haz05/TCC--Batuta_Eletronica/README.md

Batuta Eletrônica para Inclusão de Músicos com Deficiência Visual em Orquestras Sinfônicas

Vitor Fernandes Bastos Pasqualino - Universidade Federal de Santa Maria
