haz05/TCC--Batuta_Eletronica/Dados/Dados-Emissor/teste-vitor.csv

Sample Number (1000 samples per second) | UNIX Timestamp (Milliseconds since 1970-01-01) | aX () | aY () | aZ () | gX () | gY () | gZ () | sinal () | validação ()
0 | 1650320267236 | 22.0 | -564.0 | -825.0 | -2.0 | -6.0 | -6.0 | 0.0 | 0.0
1 | 1650320267239 | 22.0 | -565.0 | -822.0 | -2.0 | -6.0 | -6.0 | 0.0 | 0.0
2 | 1650320267244 | 22.0 | -566.0 | -817.0 | -2.0 | -7.0 | -6.0 | 0.0 | 0.0
3 | 1650320267253 | 21.0 | -567.0 | -813.0 | -1.0 | -7.0 | -5.0 | 0.0 | 0.0
4 | 1650320267259 | 19.0 | -568.0 | -810.0 | -1.0 | -7.0 | -4.0 | 0.0 | 0.0
5 | 1650320267269 | 16.0 | -569.0 | -808.0 | 0.0 | -6.0 | -3.0 | 0.0 | 0.0
6 | 1650320267276 | 15.0 | -569.0 | -805.0 | 0.0 | -6.0 | -2.0 | 0.0 | 0.0
7 | 1650320267285 | 13.0 | -568.0 | -804.0 | 1.0 | -5.0 | -1.0 | 0.0 | 0.0
8 | 1650320267292 | 13.0 | -567.0 | -804.0 | 2.0 | -5.0 | 0.0 | 0.0 | 0.0
9 | 1650320267301 | 15.0 | -564.0 | -805.0 | 3.0 | -5.0 | 0.0 | 0.0 | 0.0
10 | 1650320267307 | 18.0 | -561.0 | -806.0 | 4.0 | -4.0 | 1.0 | 0.0 | 0.0
11 | 1650320267317 | 22.0 | -558.0 | -808.0 | 4.0 | -4.0 | 2.0 | 0.0 | 0.0
12 | 1650320267325 | 28.0 | -557.0 | -809.0 | 5.0 | -3.0 | 2.0 | 0.0 | 0.0
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
