haz05/TCC--Batuta_Eletronica/Dados/Dados-Emissor/teste-vitor2.csv

Sample Number (1000 samples per second) | UNIX Timestamp (Milliseconds since 1970-01-01) | aX () | aY () | aZ () | gX () | gY () | gZ () | sinal () | validação ()
0 | 1650323412721 | 618.0 | -165.0 | -791.0 | 3.0 | -3.0 | -3.0 | 0.0 | 0.0
1 | 1650323412730 | 619.0 | -166.0 | -791.0 | 3.0 | -3.0 | -3.0 | 0.0 | 0.0
2 | 1650323412730 | 619.0 | -165.0 | -790.0 | 3.0 | -3.0 | -3.0 | 0.0 | 0.0
3 | 1650323412730 | 619.0 | -165.0 | -790.0 | 3.0 | -3.0 | -3.0 | 0.0 | 0.0
4 | 1650323412730 | 619.0 | -165.0 | -790.0 | 3.0 | -3.0 | -3.0 | 0.0 | 0.0
5 | 1650323412738 | 618.0 | -164.0 | -790.0 | 3.0 | -3.0 | -3.0 | 0.0 | 0.0
6 | 1650323412745 | 618.0 | -165.0 | -789.0 | 3.0 | -3.0 | -3.0 | 0.0 | 0.0
7 | 1650323412753 | 618.0 | -165.0 | -789.0 | 3.0 | -2.0 | -3.0 | 0.0 | 0.0
8 | 1650323412760 | 619.0 | -165.0 | -789.0 | 3.0 | -2.0 | -3.0 | 0.0 | 0.0
9 | 1650323412771 | 619.0 | -165.0 | -789.0 | 3.0 | -2.0 | -3.0 | 0.0 | 0.0
10 | 1650323412776 | 620.0 | -165.0 | -789.0 | 2.0 | -2.0 | -3.0 | 0.0 | 0.0
11 | 1650323412785 | 620.0 | -165.0 | -789.0 | 2.0 | -3.0 | -3.0 | 0.0 | 0.0
12 | 1650323412794 | 620.0 | -166.0 | -789.0 | 2.0 | -3.0 | -3.0 | 0.0 | 0.0
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
