haz05/TCC--Batuta_Eletronica/Arquivos/Documentos_CAD/placa_E1.pdf

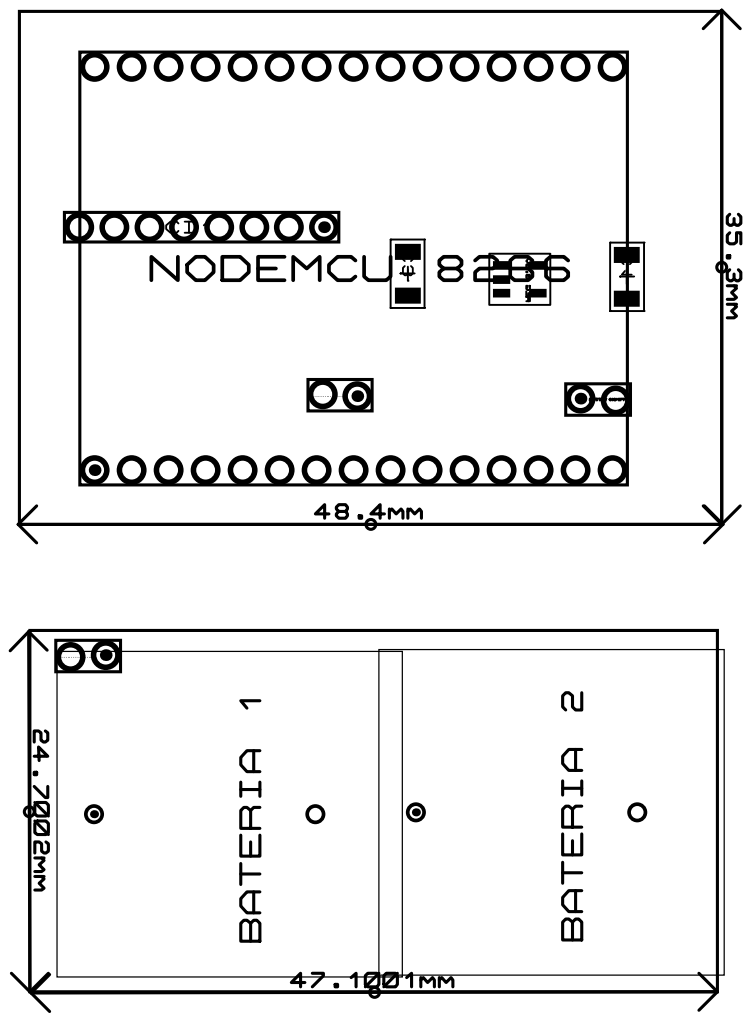
[picture p62: page 1]
