haz05/TCC--Batuta_Eletronica/Arquivos/Documentos_CAD/placa_E2.pdf

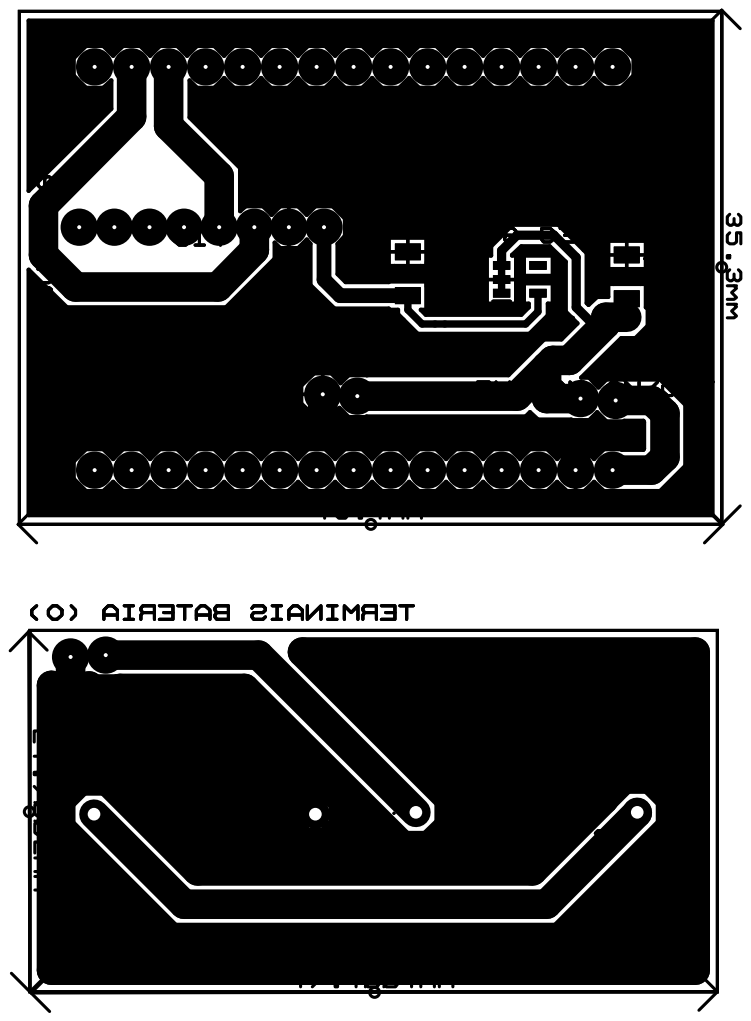
[picture p63: page 1]
