haz05/TCC--Batuta_Eletronica/Arquivos/Bibliografia/1- Introducao/Lei_7853.pdf

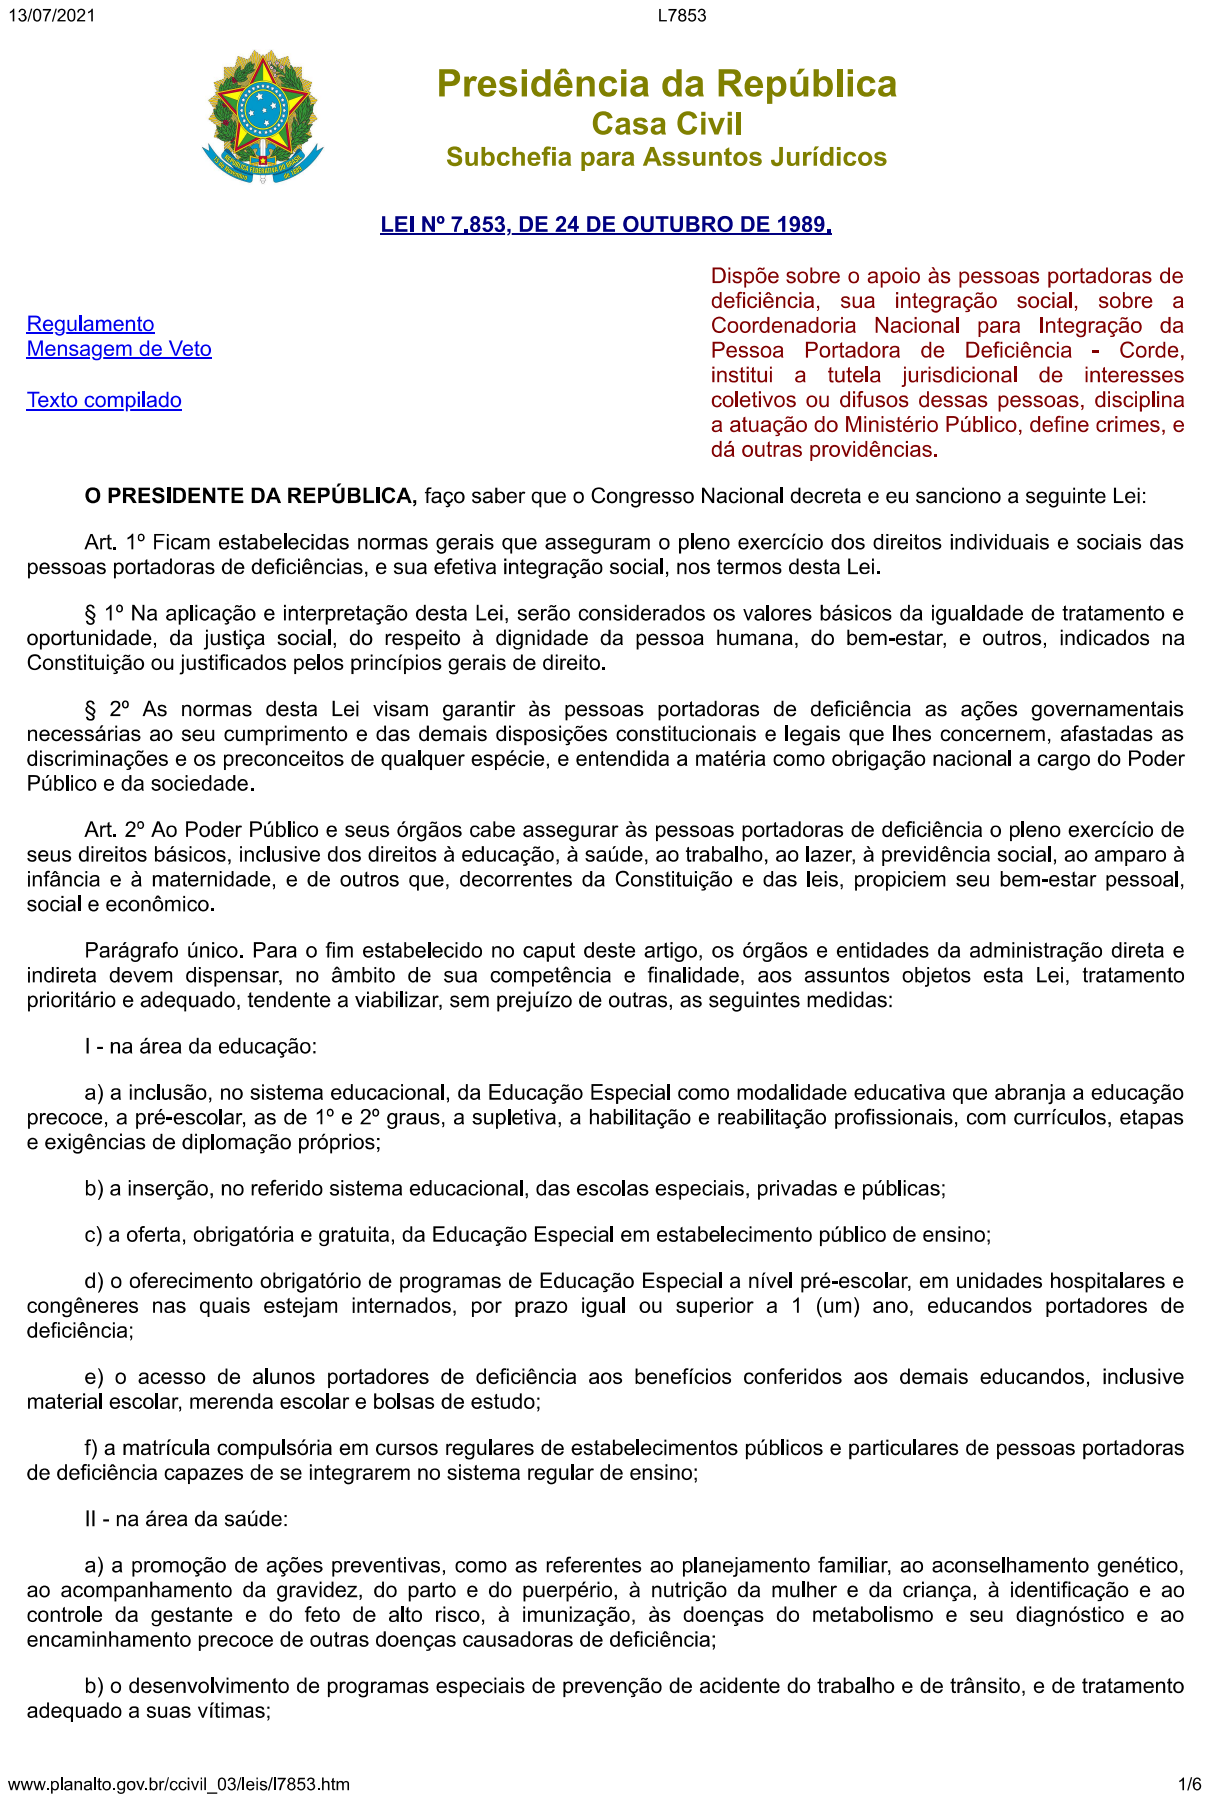
[picture p64: page 1]

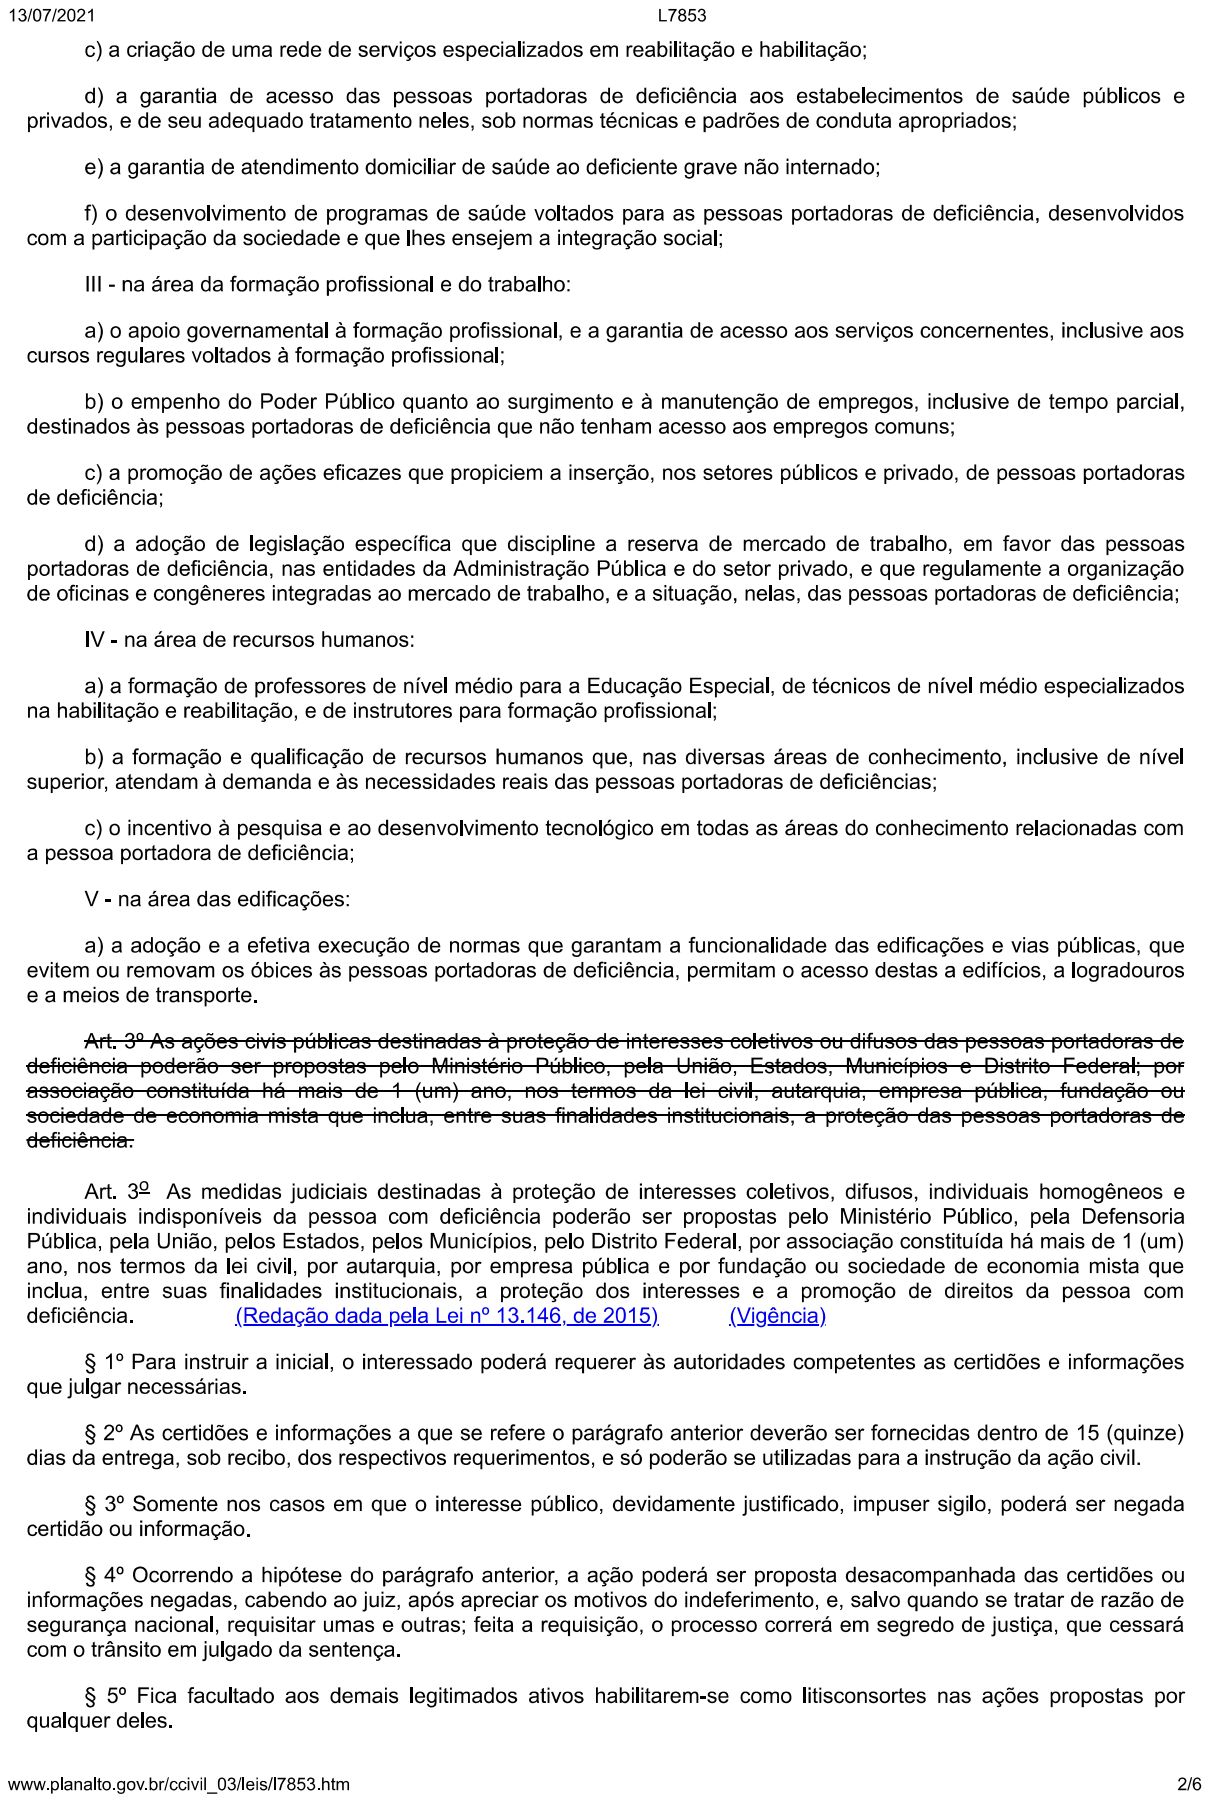
[picture p65: page 2]

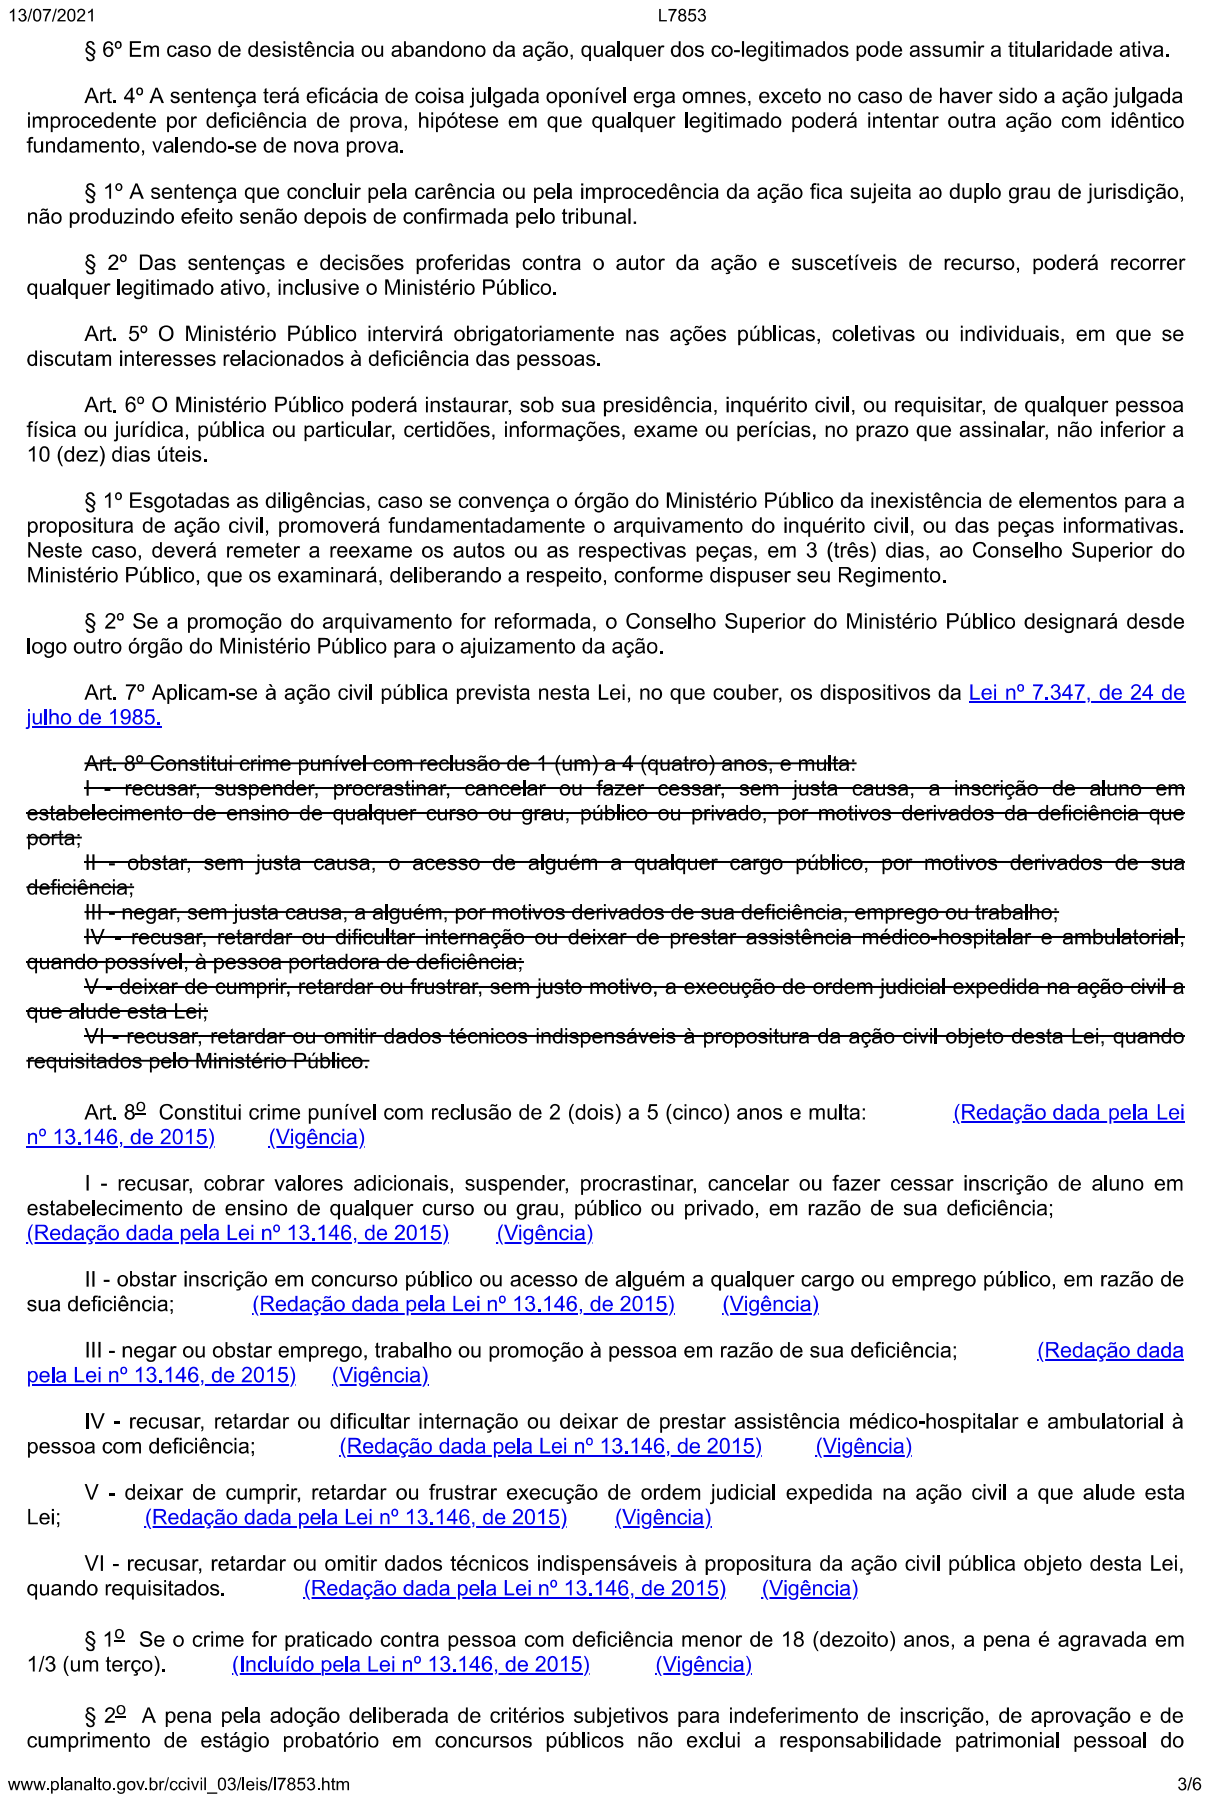
[picture p66: page 3]

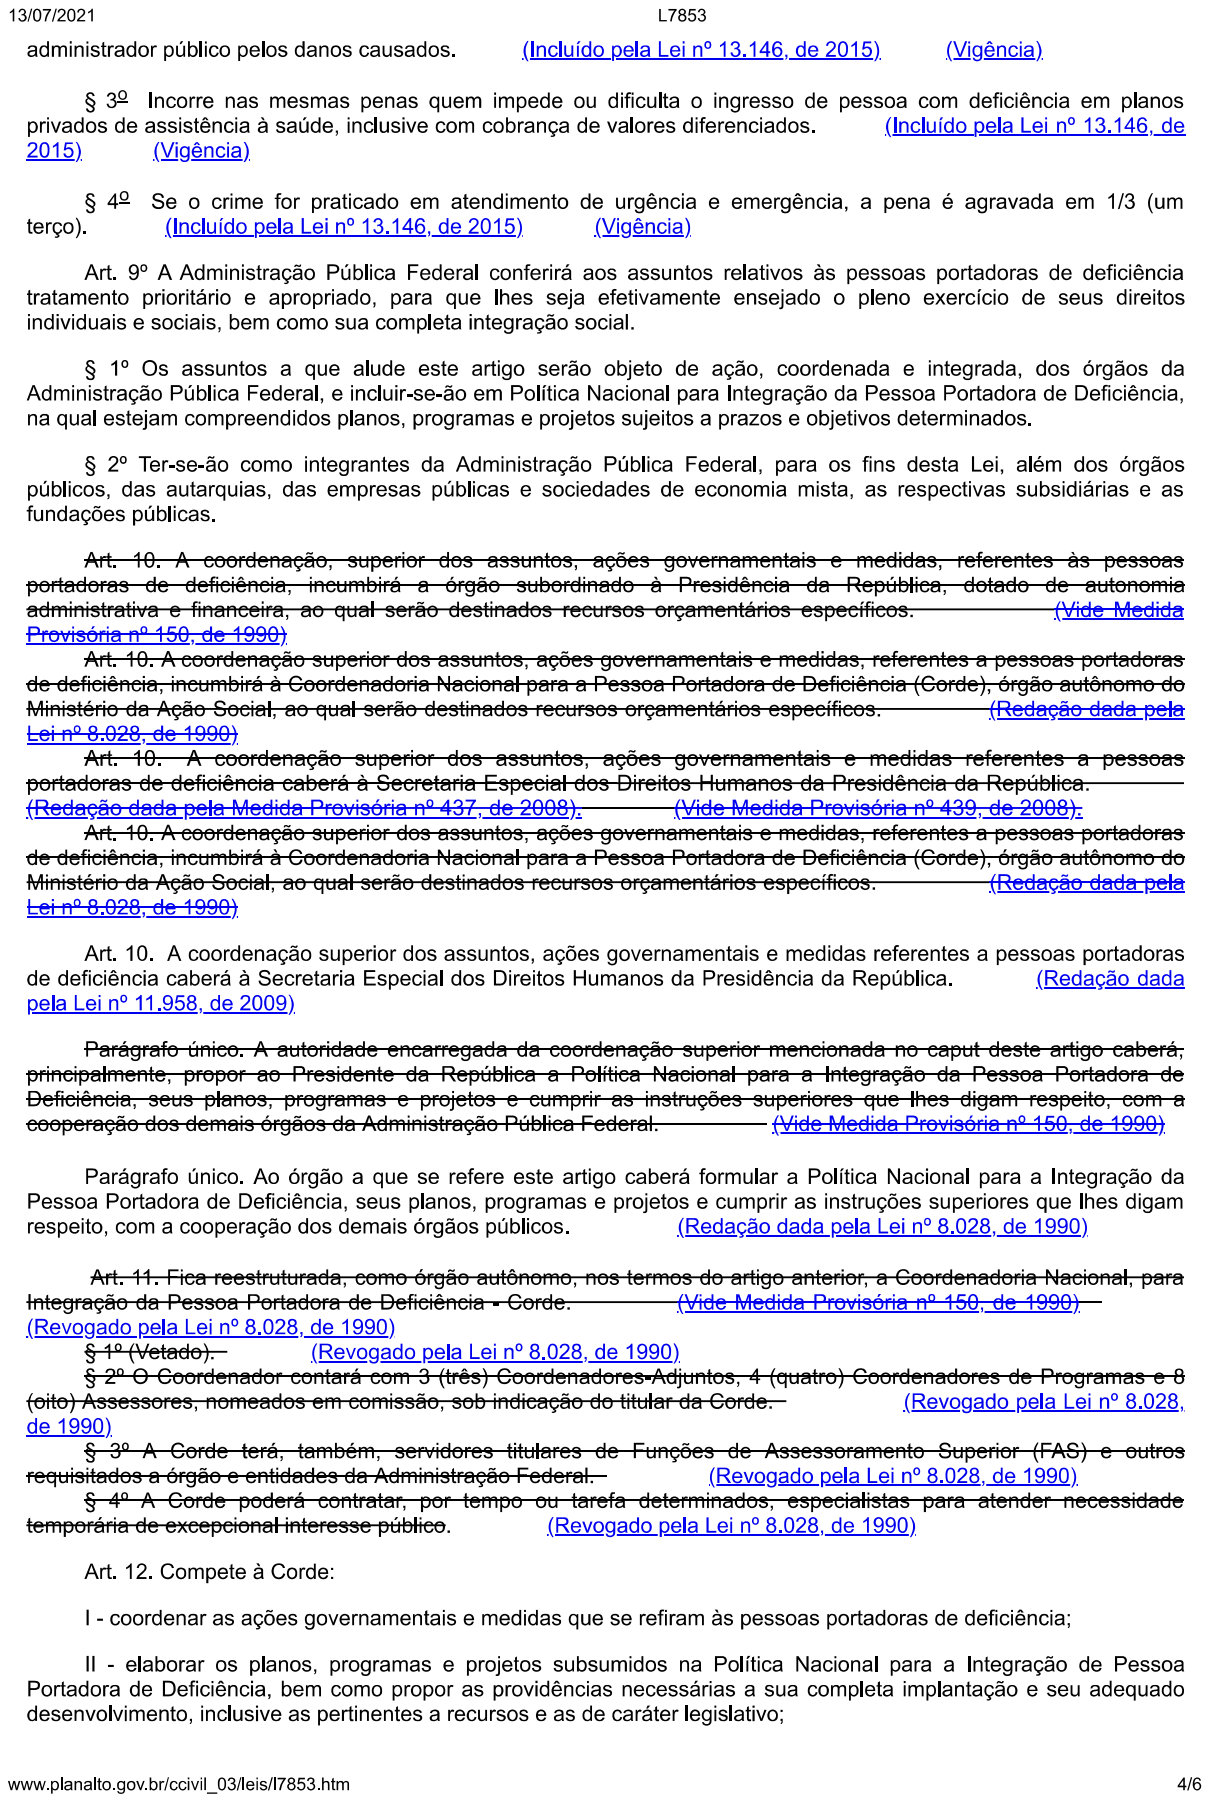
[picture p67: page 4]

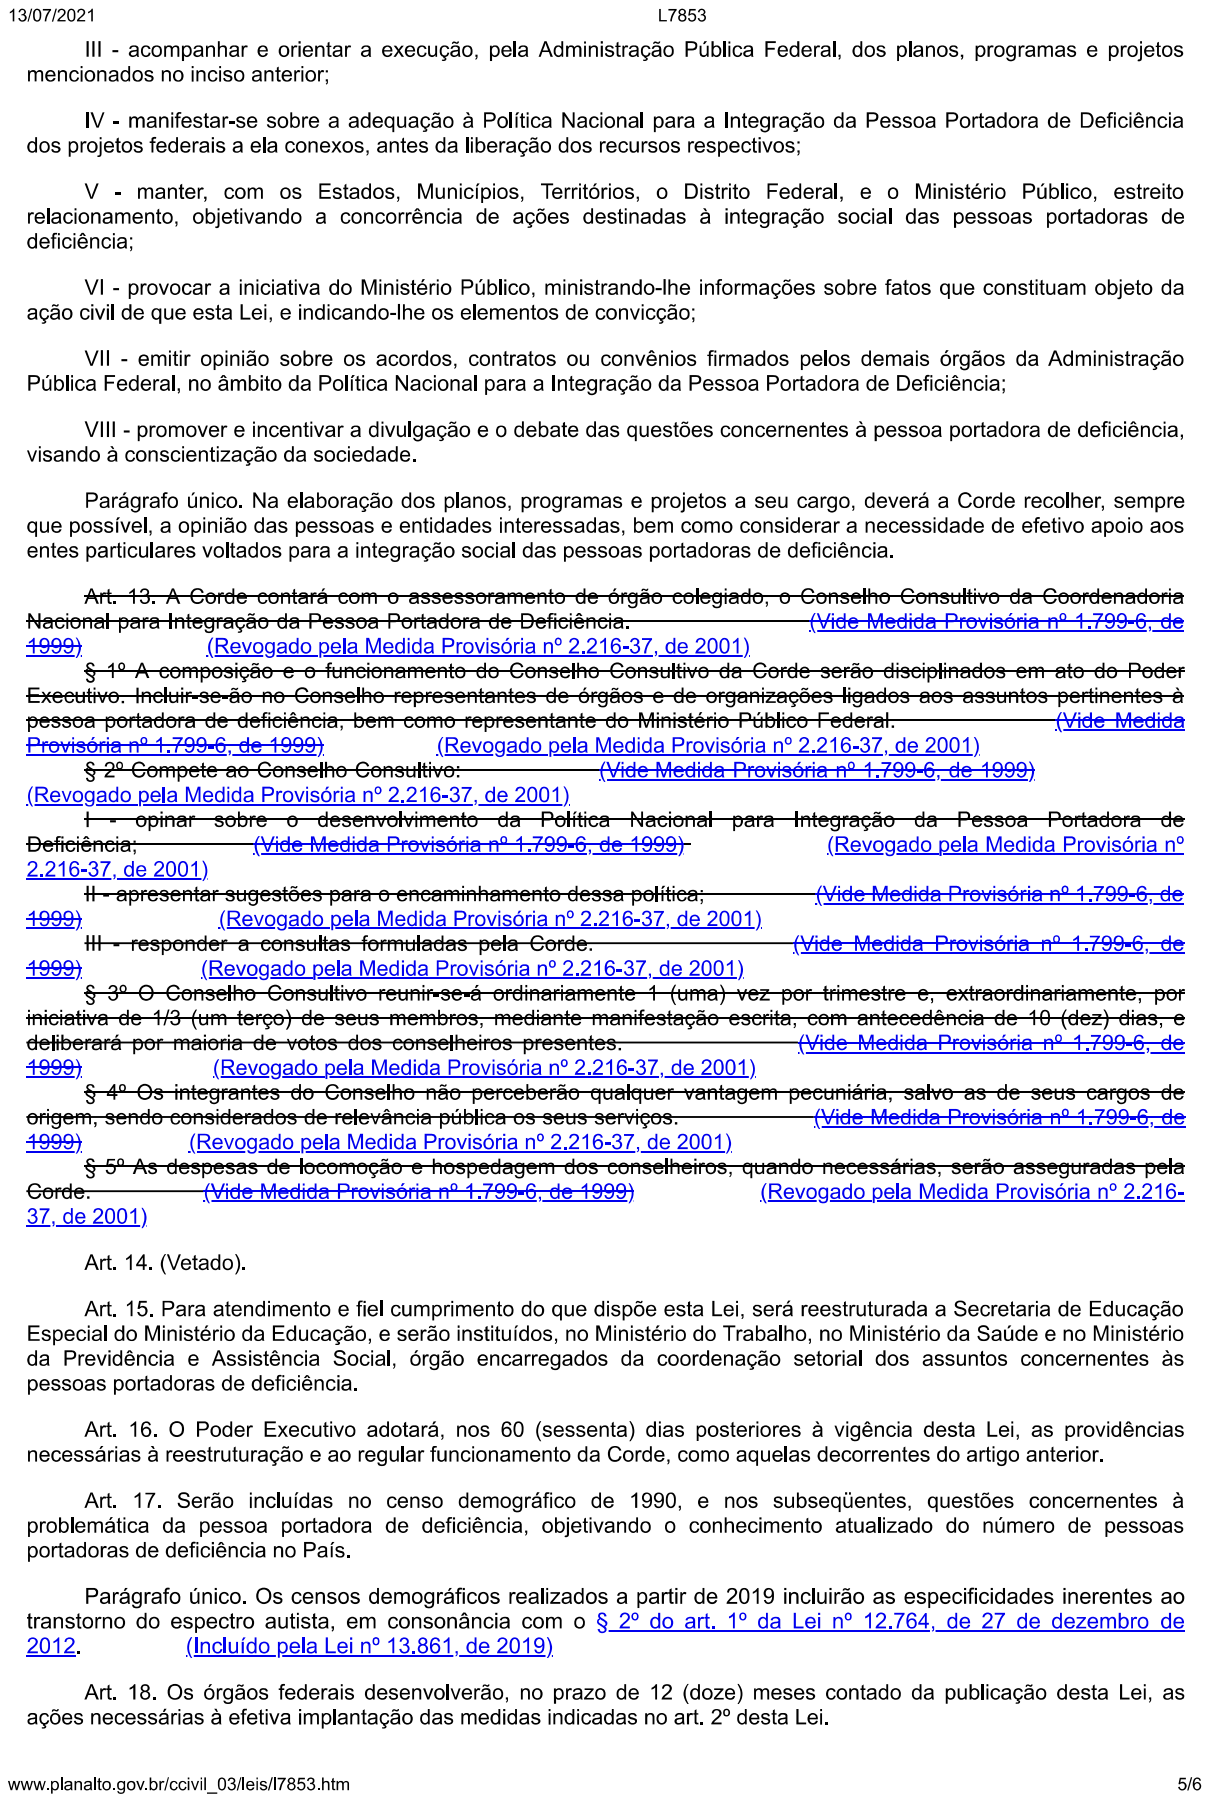
[picture p68: page 5]

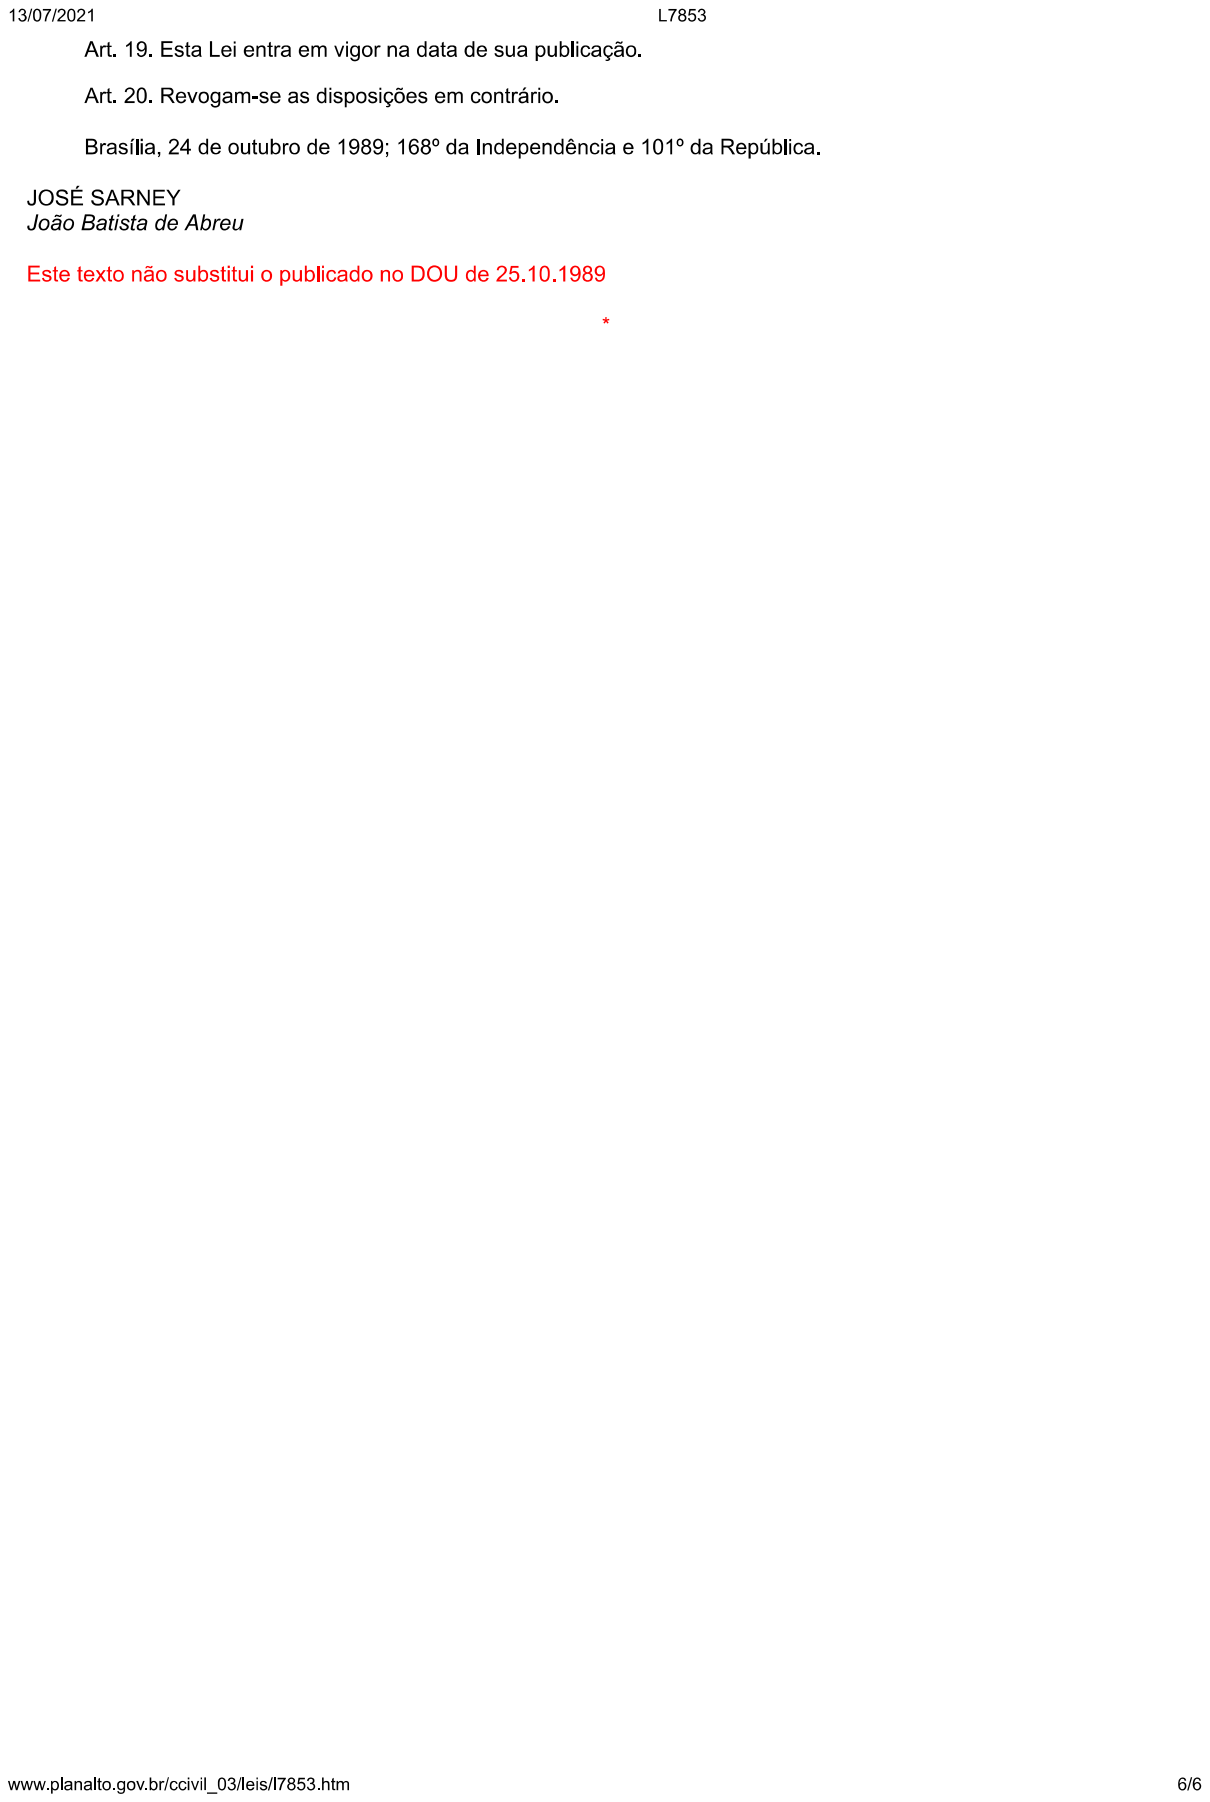
[picture p69: page 6]
