haz05/TCC--Batuta_Eletronica/Arquivos/Bibliografia/Nao_Usados/acelerometro_mercado_livre.pdf

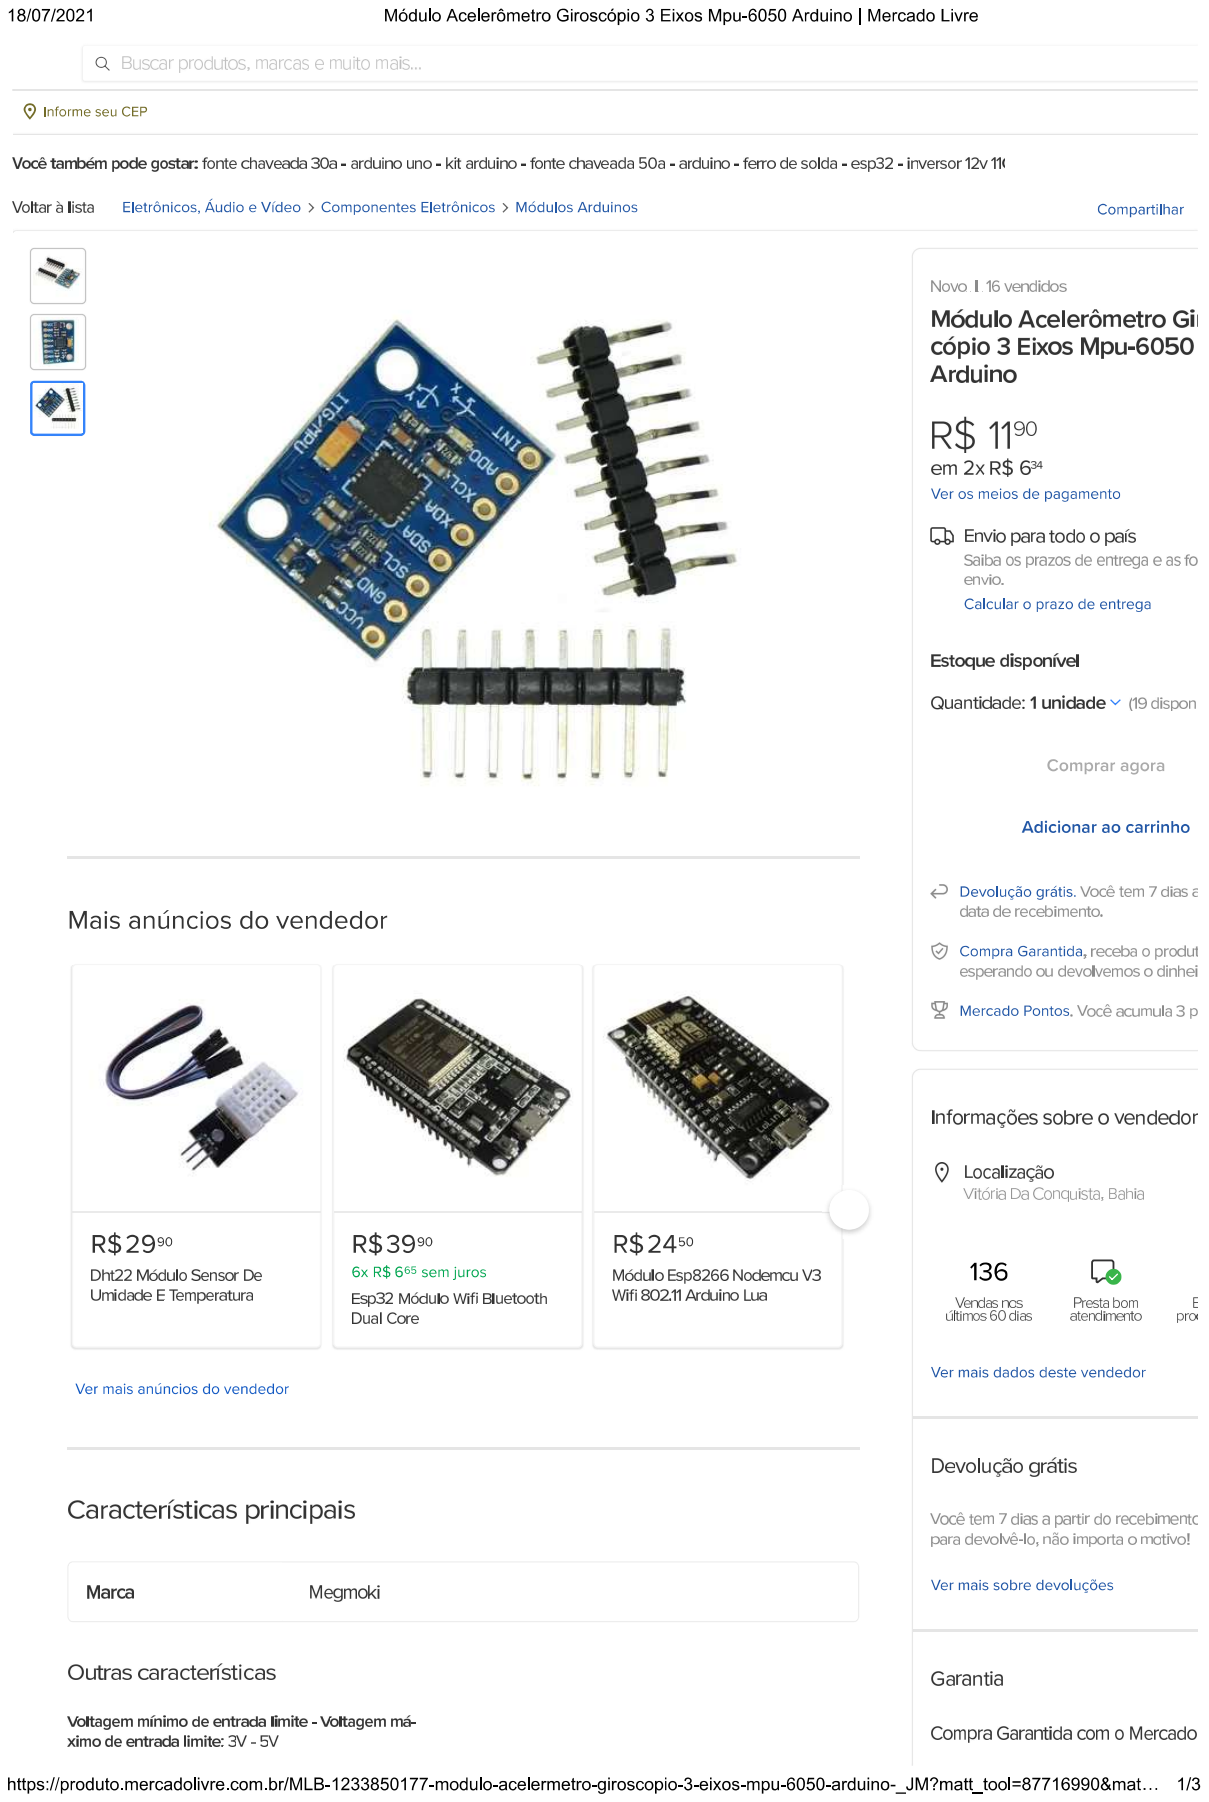
[picture p70: page 1]

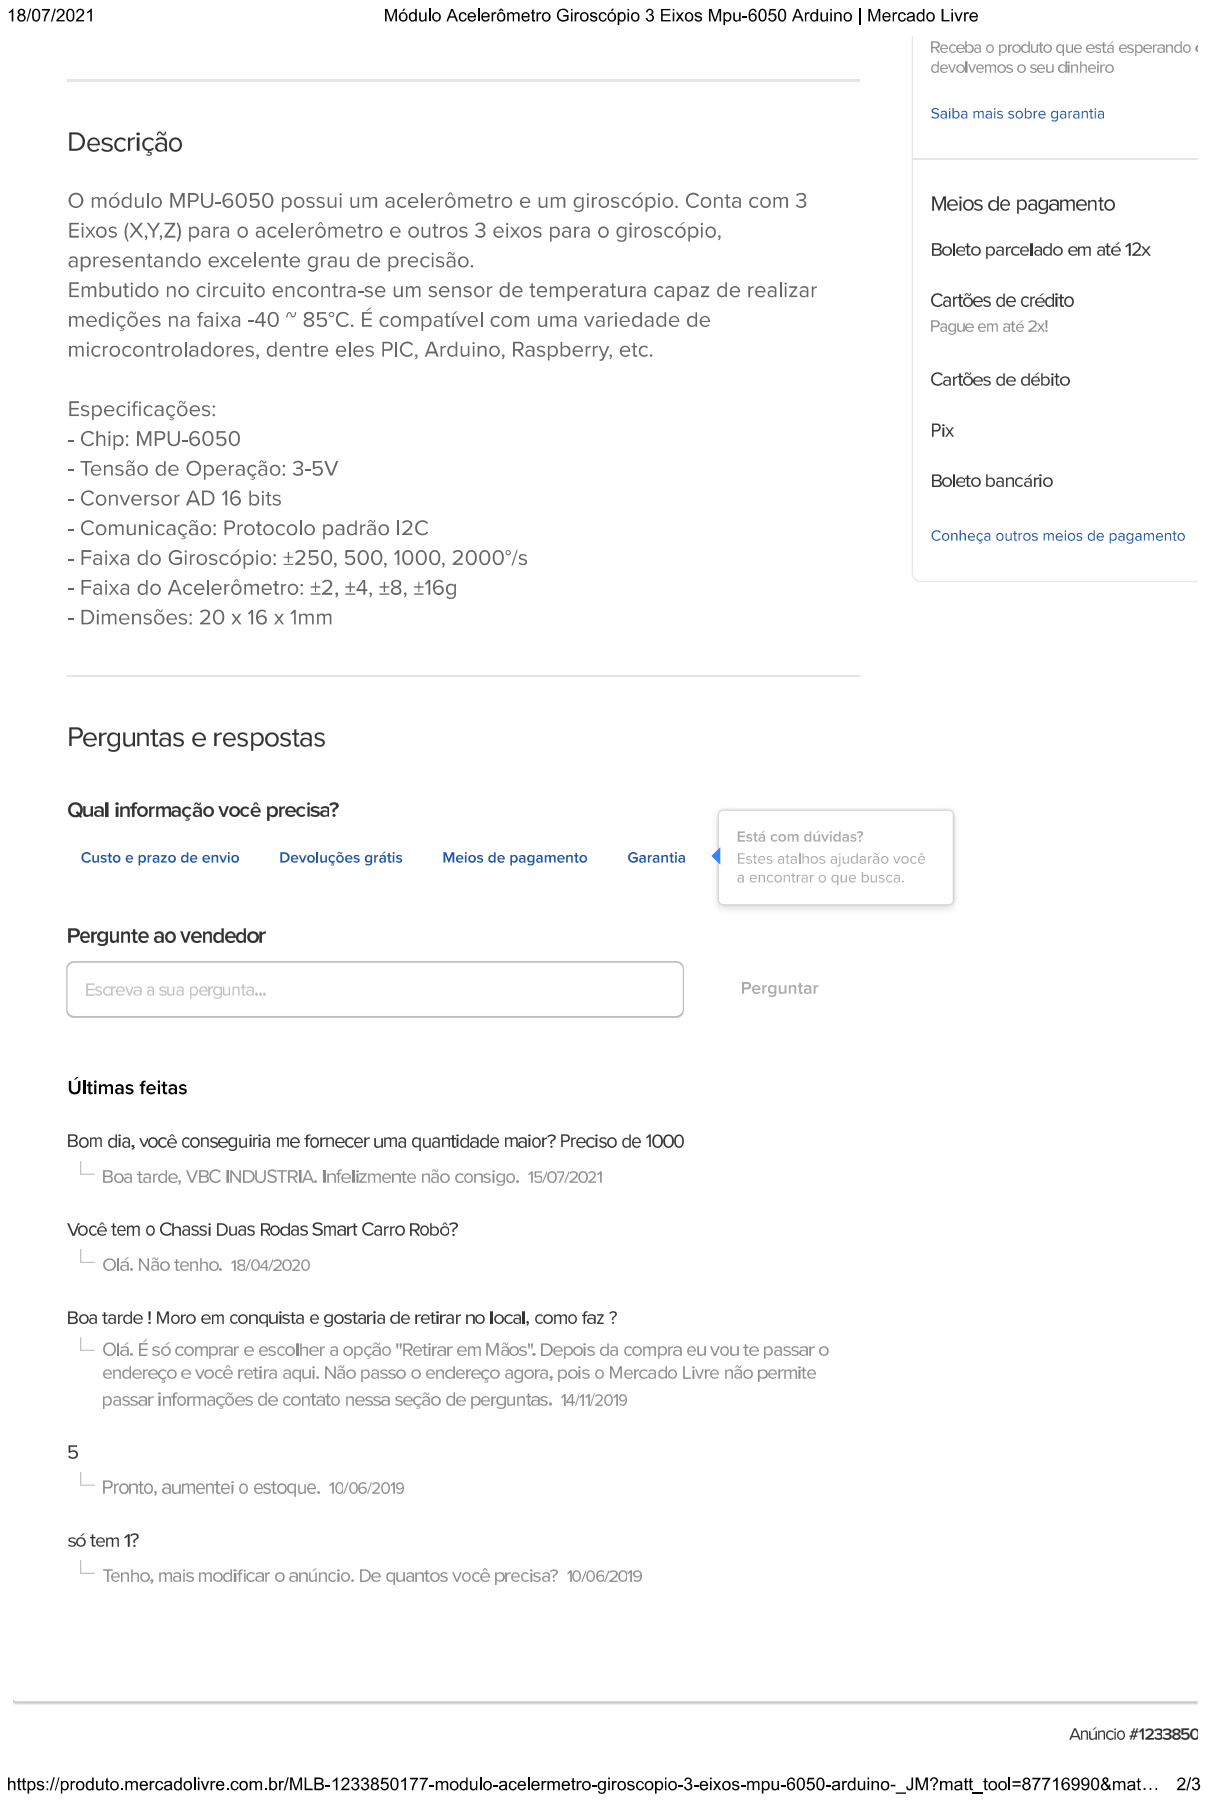
[picture p71: page 2]

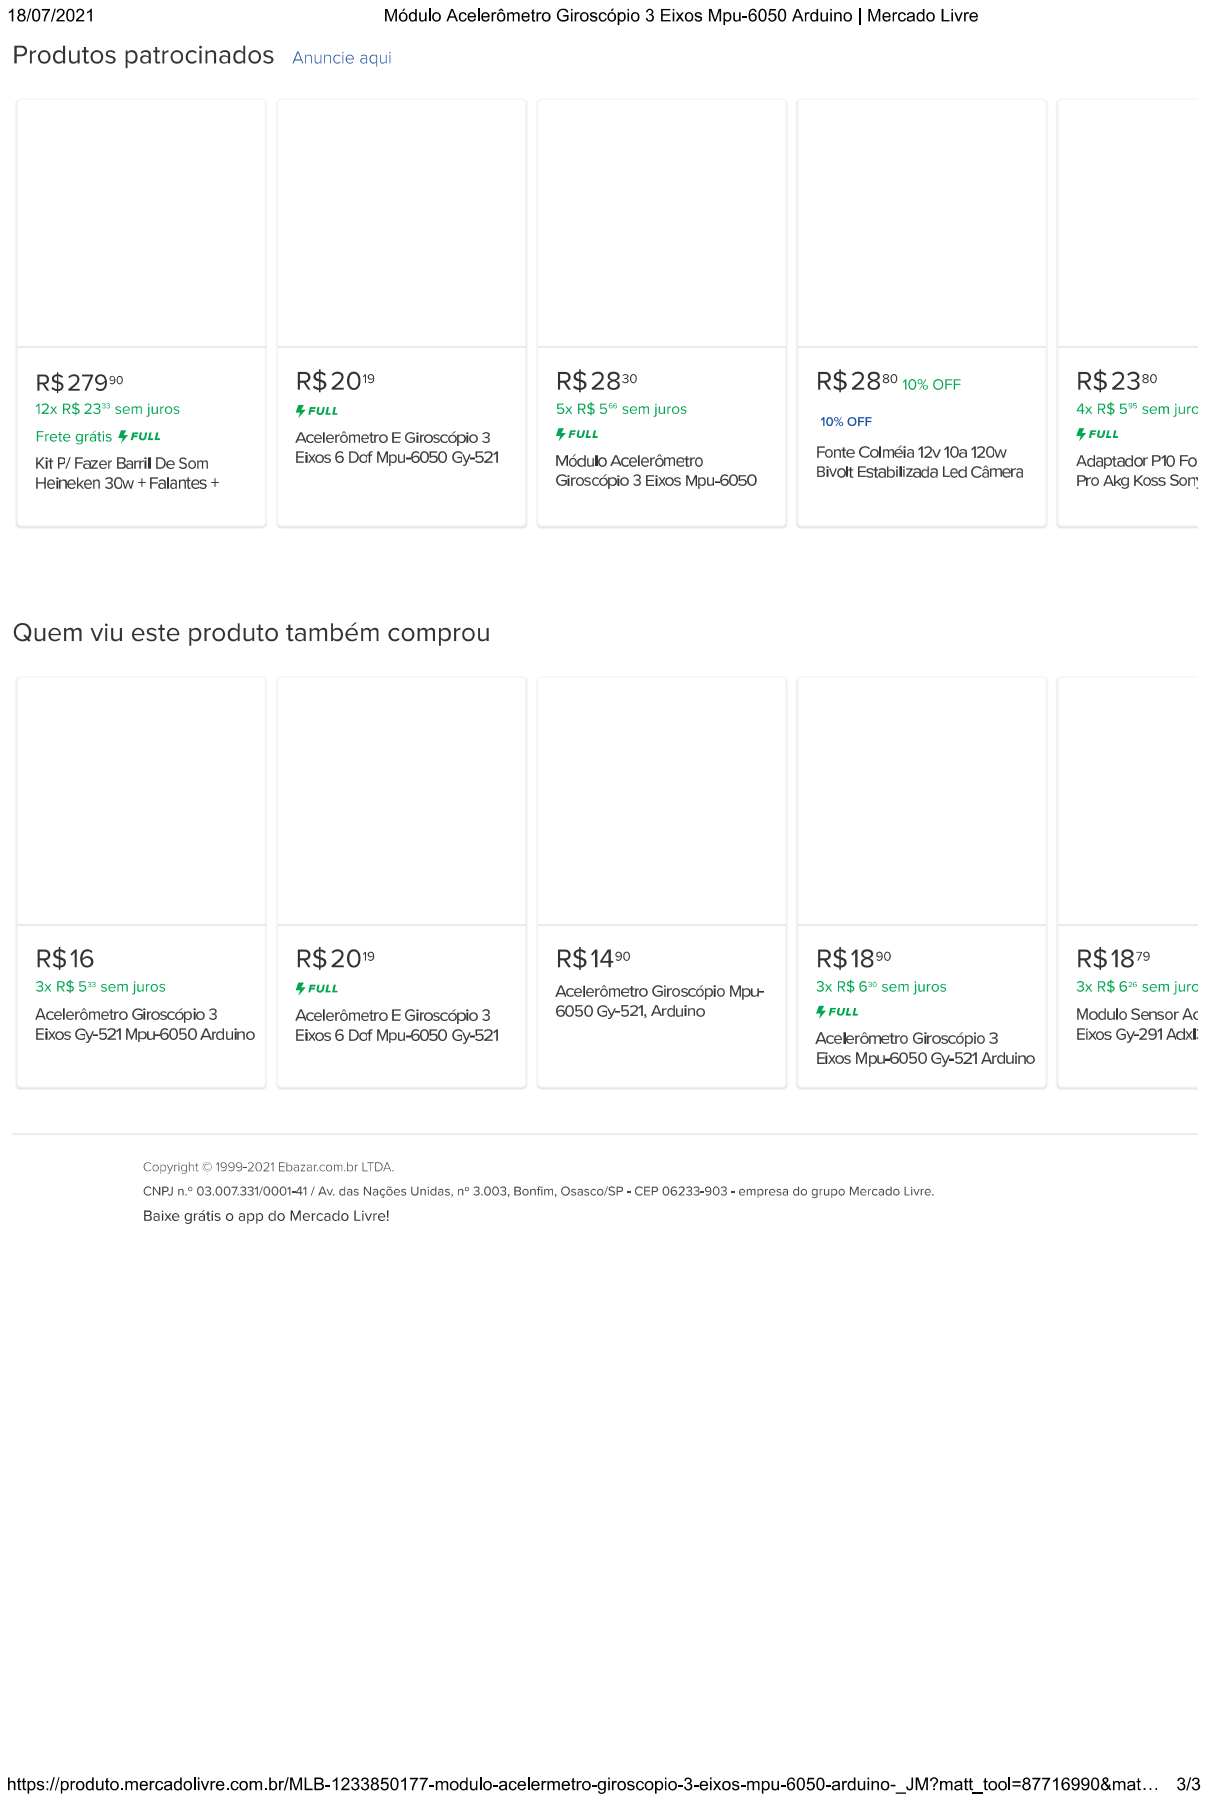
[picture p72: page 3]
