haz05/TCC--Batuta_Eletronica/Arquivos/Bibliografia/2- Ref Bibliograficas/1-ESP/ESP8266_Mouser_Eletronics.pdf

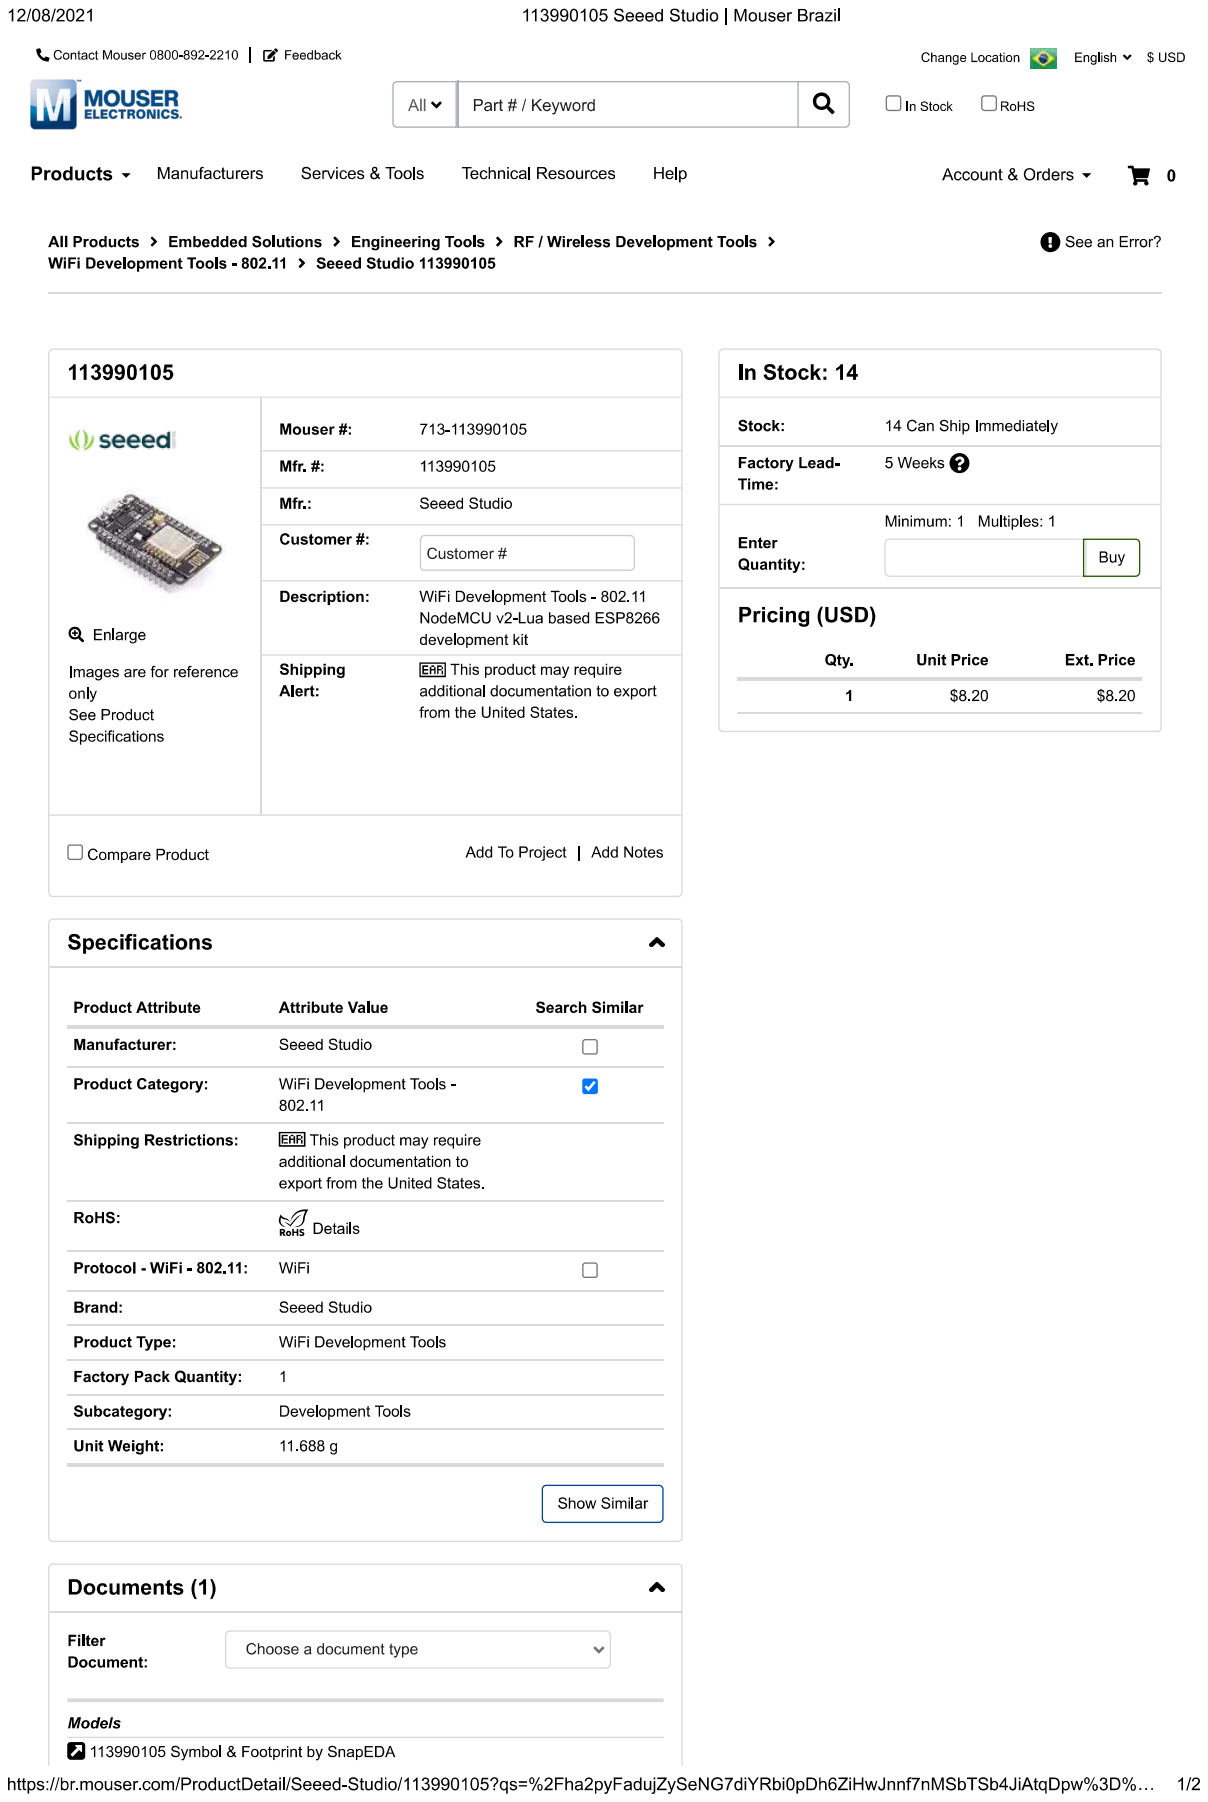
[picture p73: page 1]

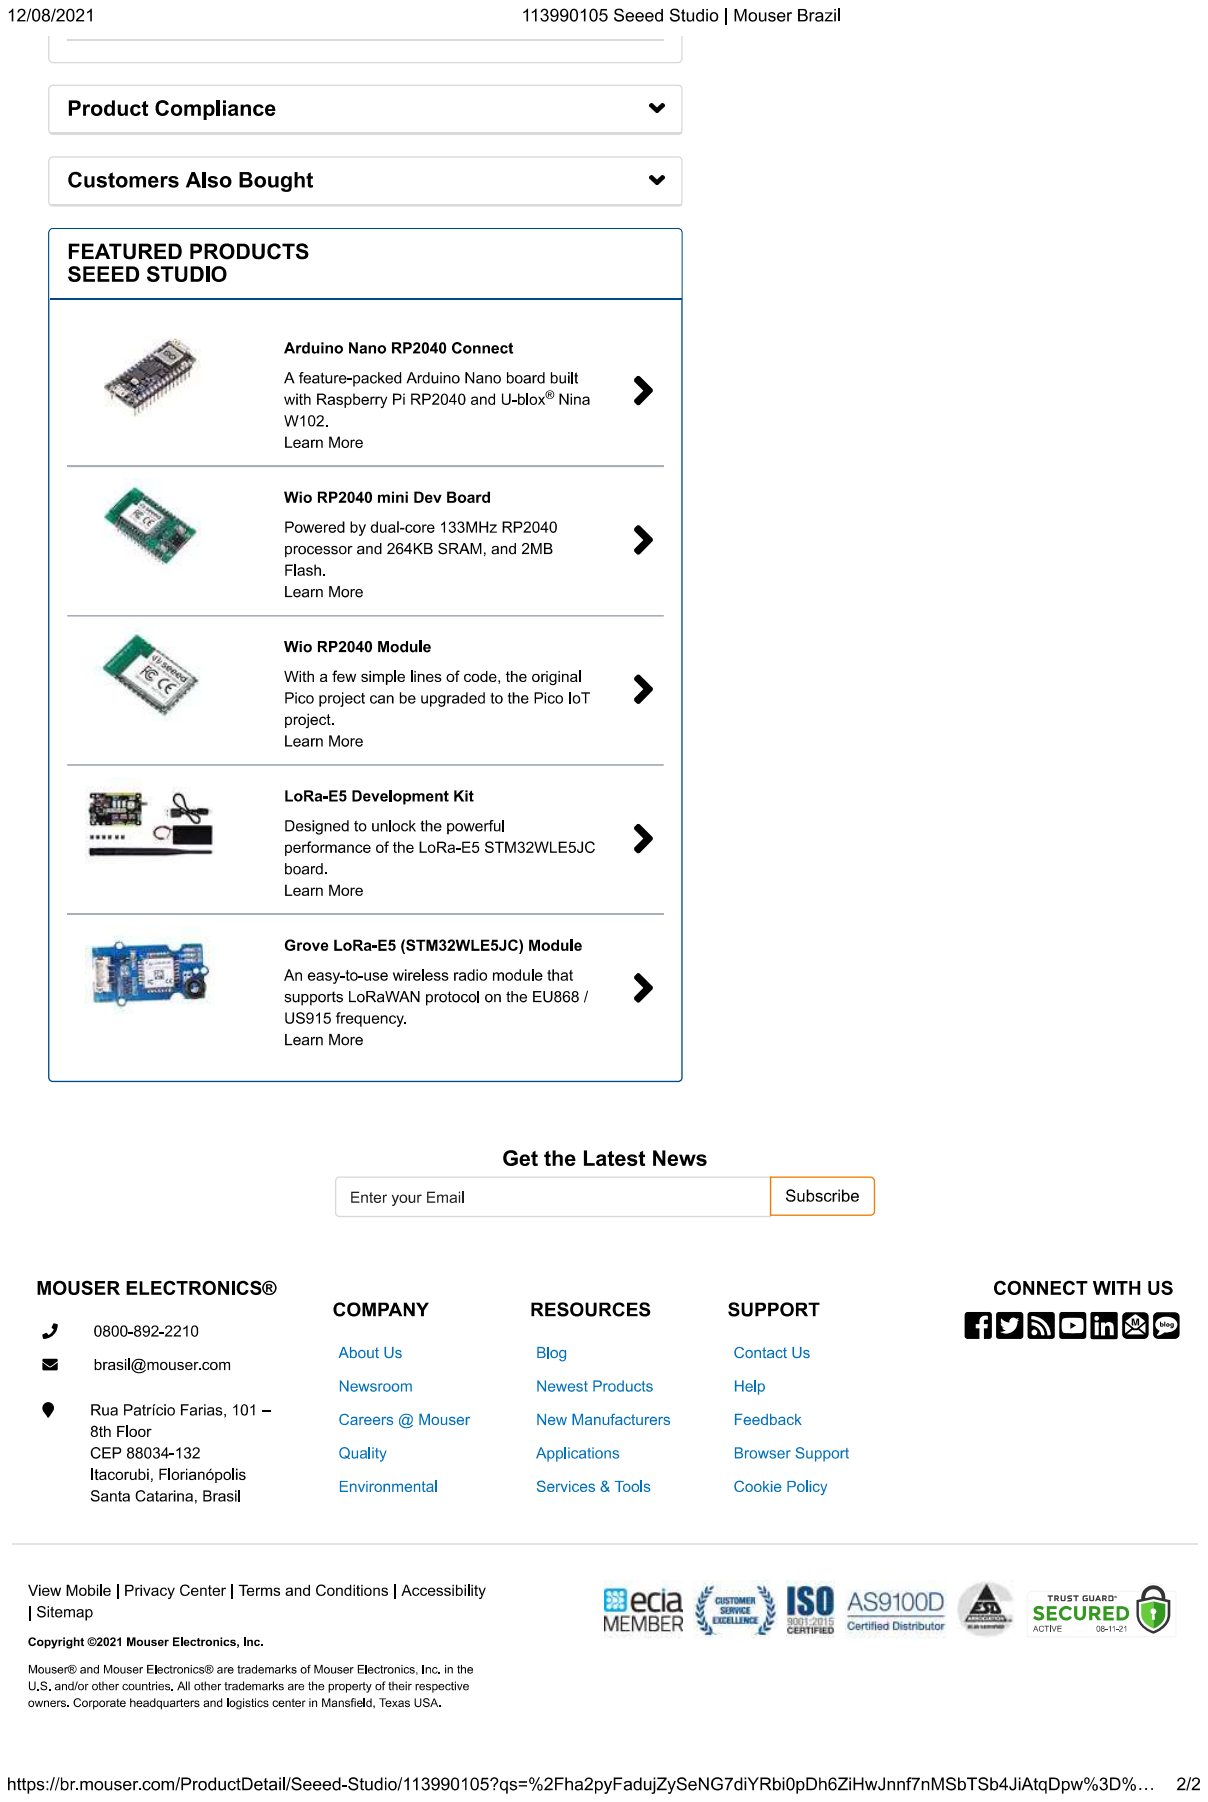
[picture p74: page 2]
