haz05/TCC--Batuta_Eletronica/Arquivos/Bibliografia/2- Ref Bibliograficas/2-WIFI/NASSCOM_SetPoint_and_WIFIStation_site.pdf

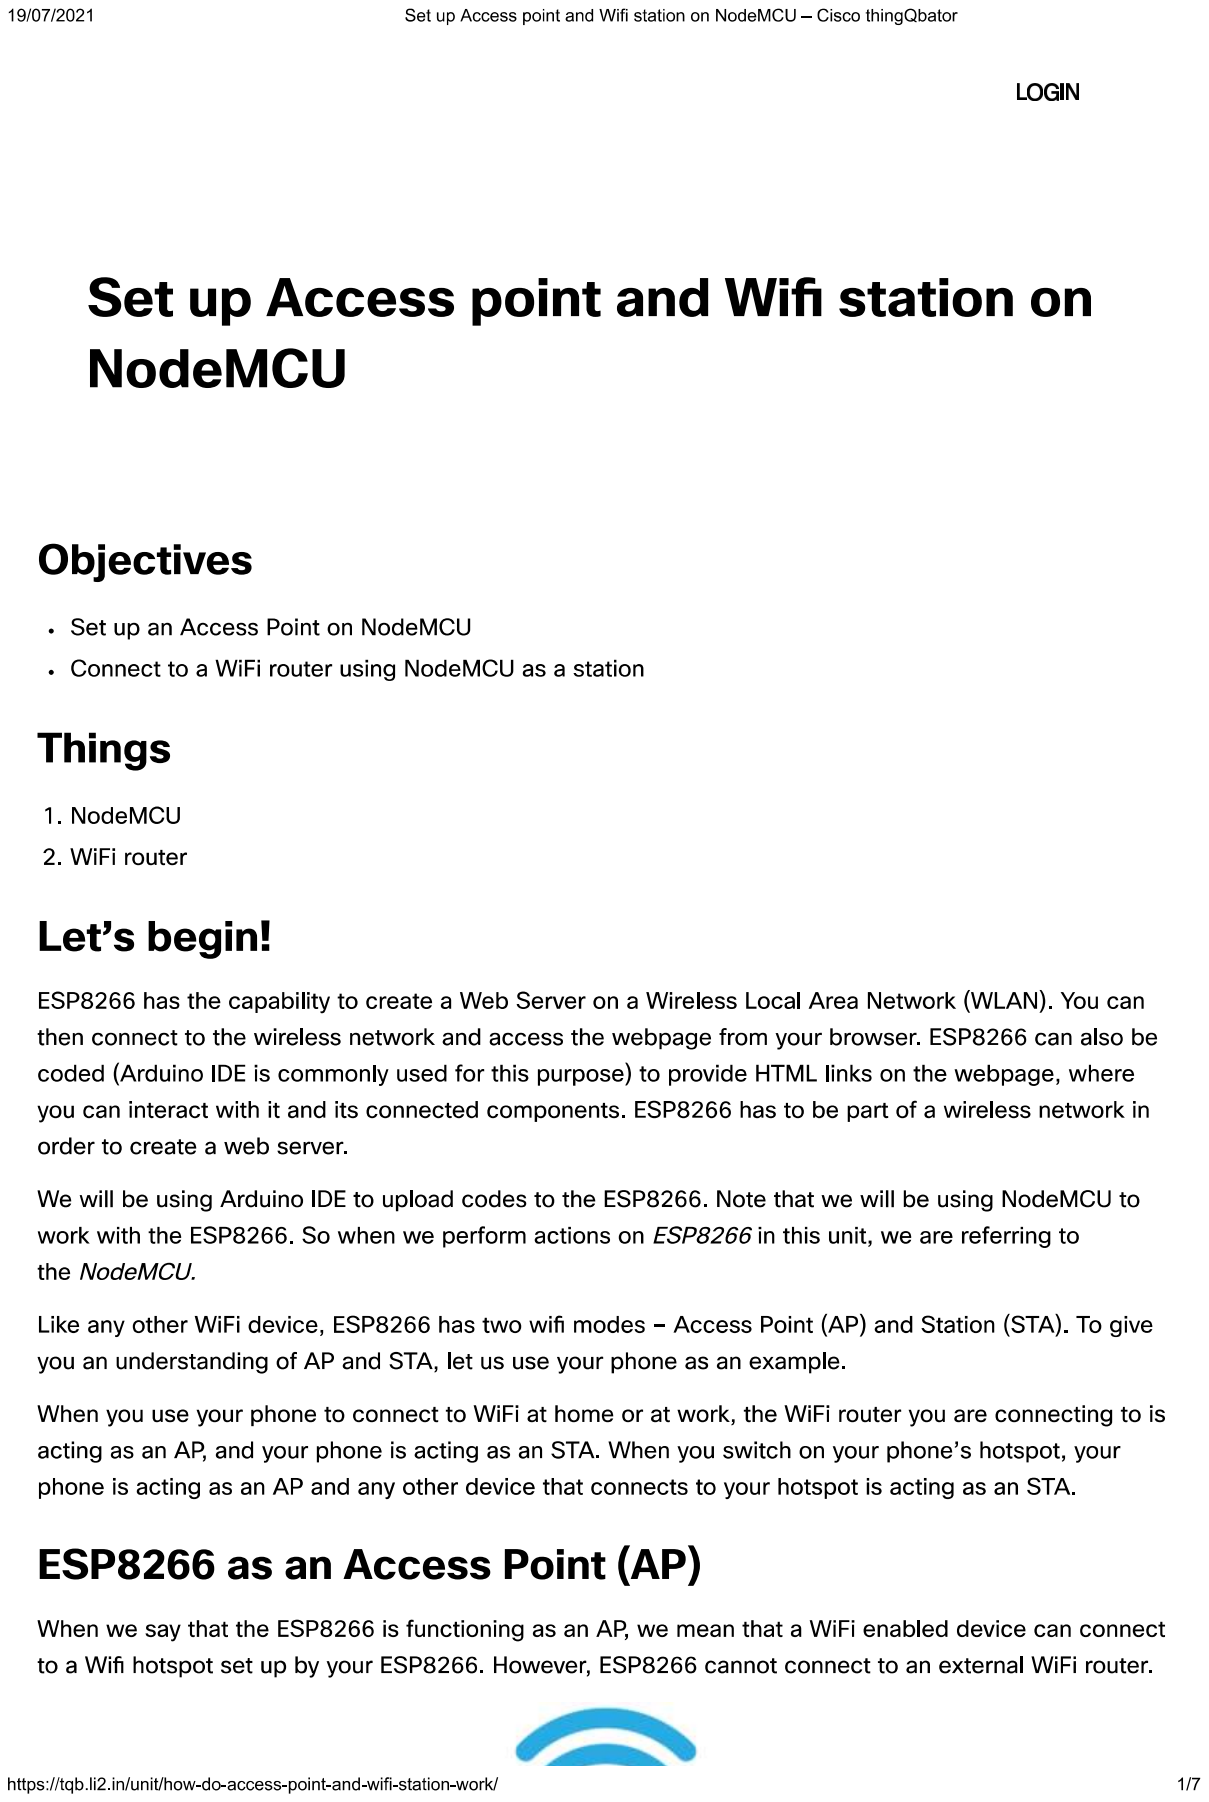
[picture p75: page 1]

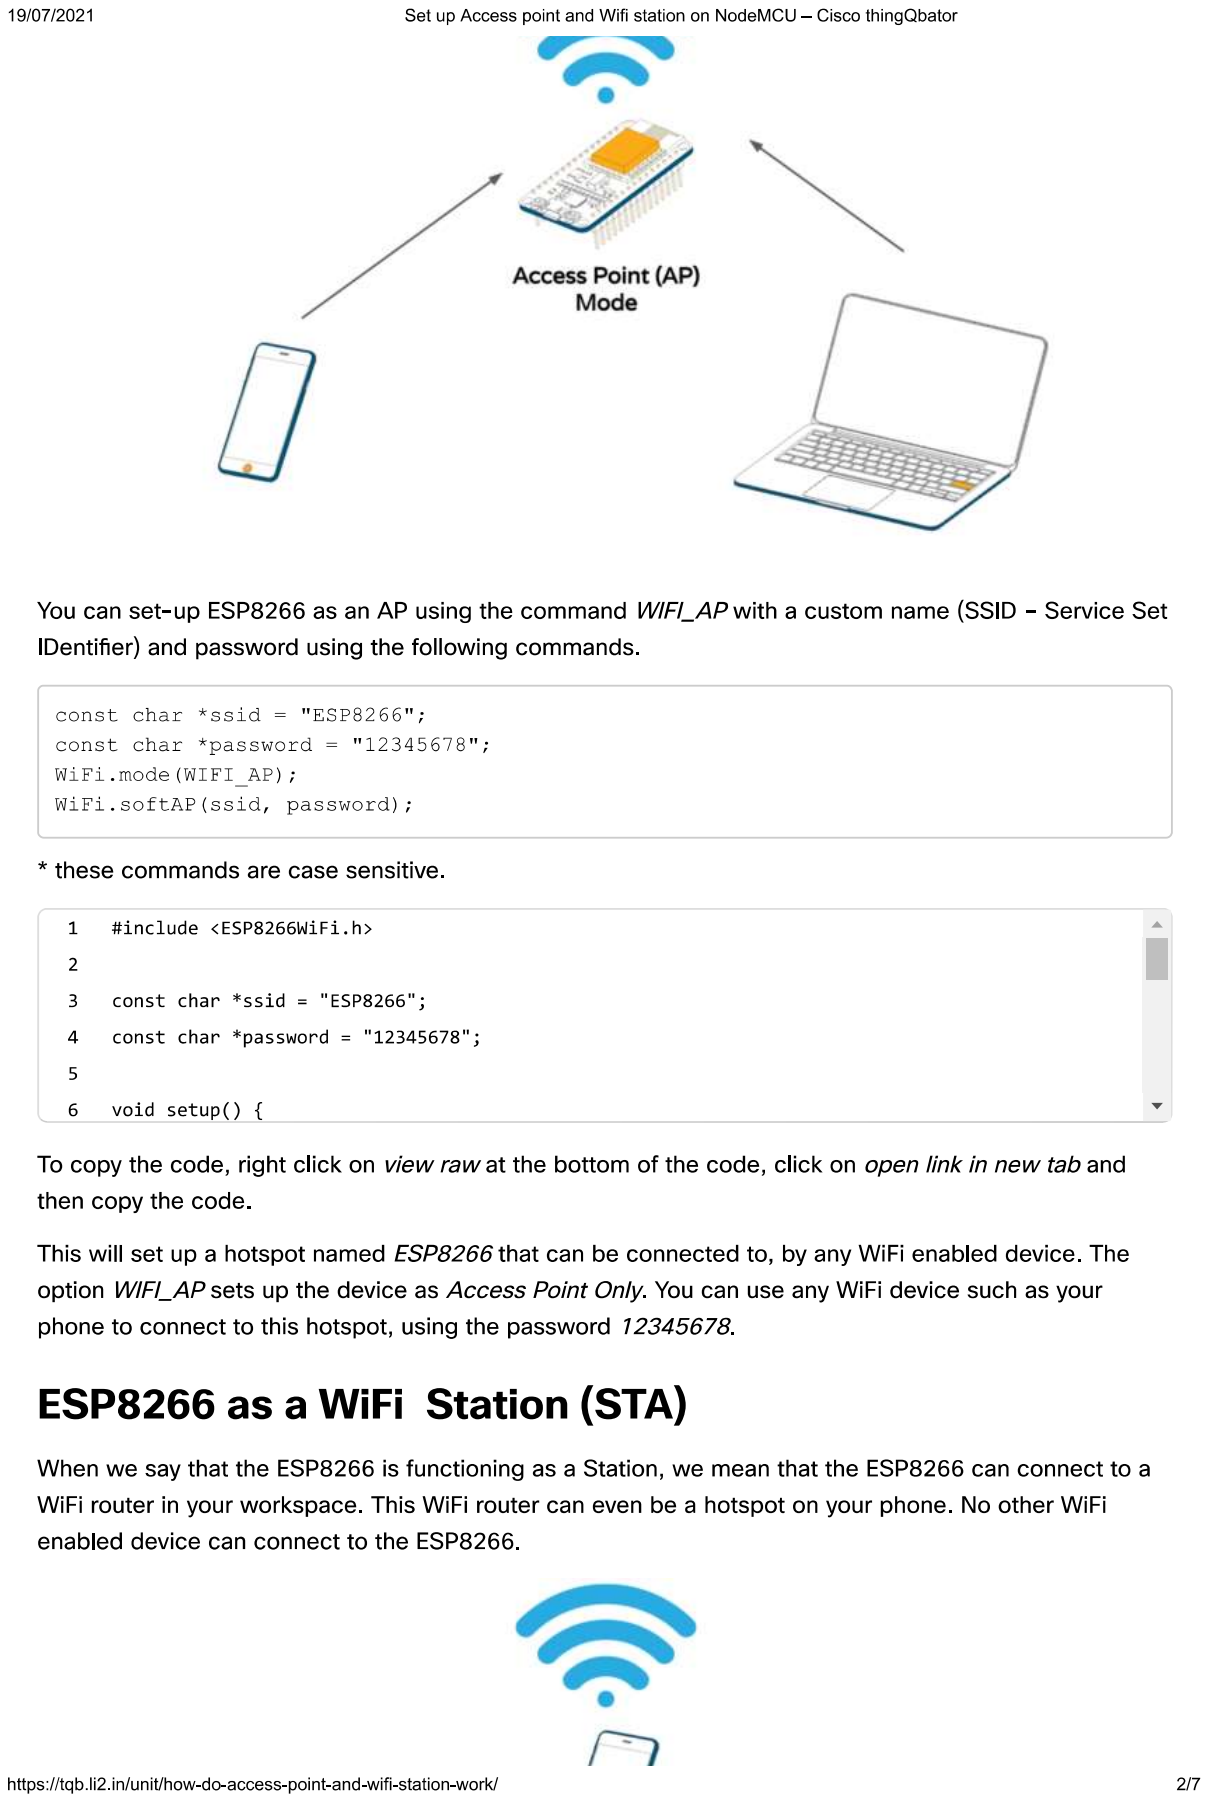
[picture p76: page 2]

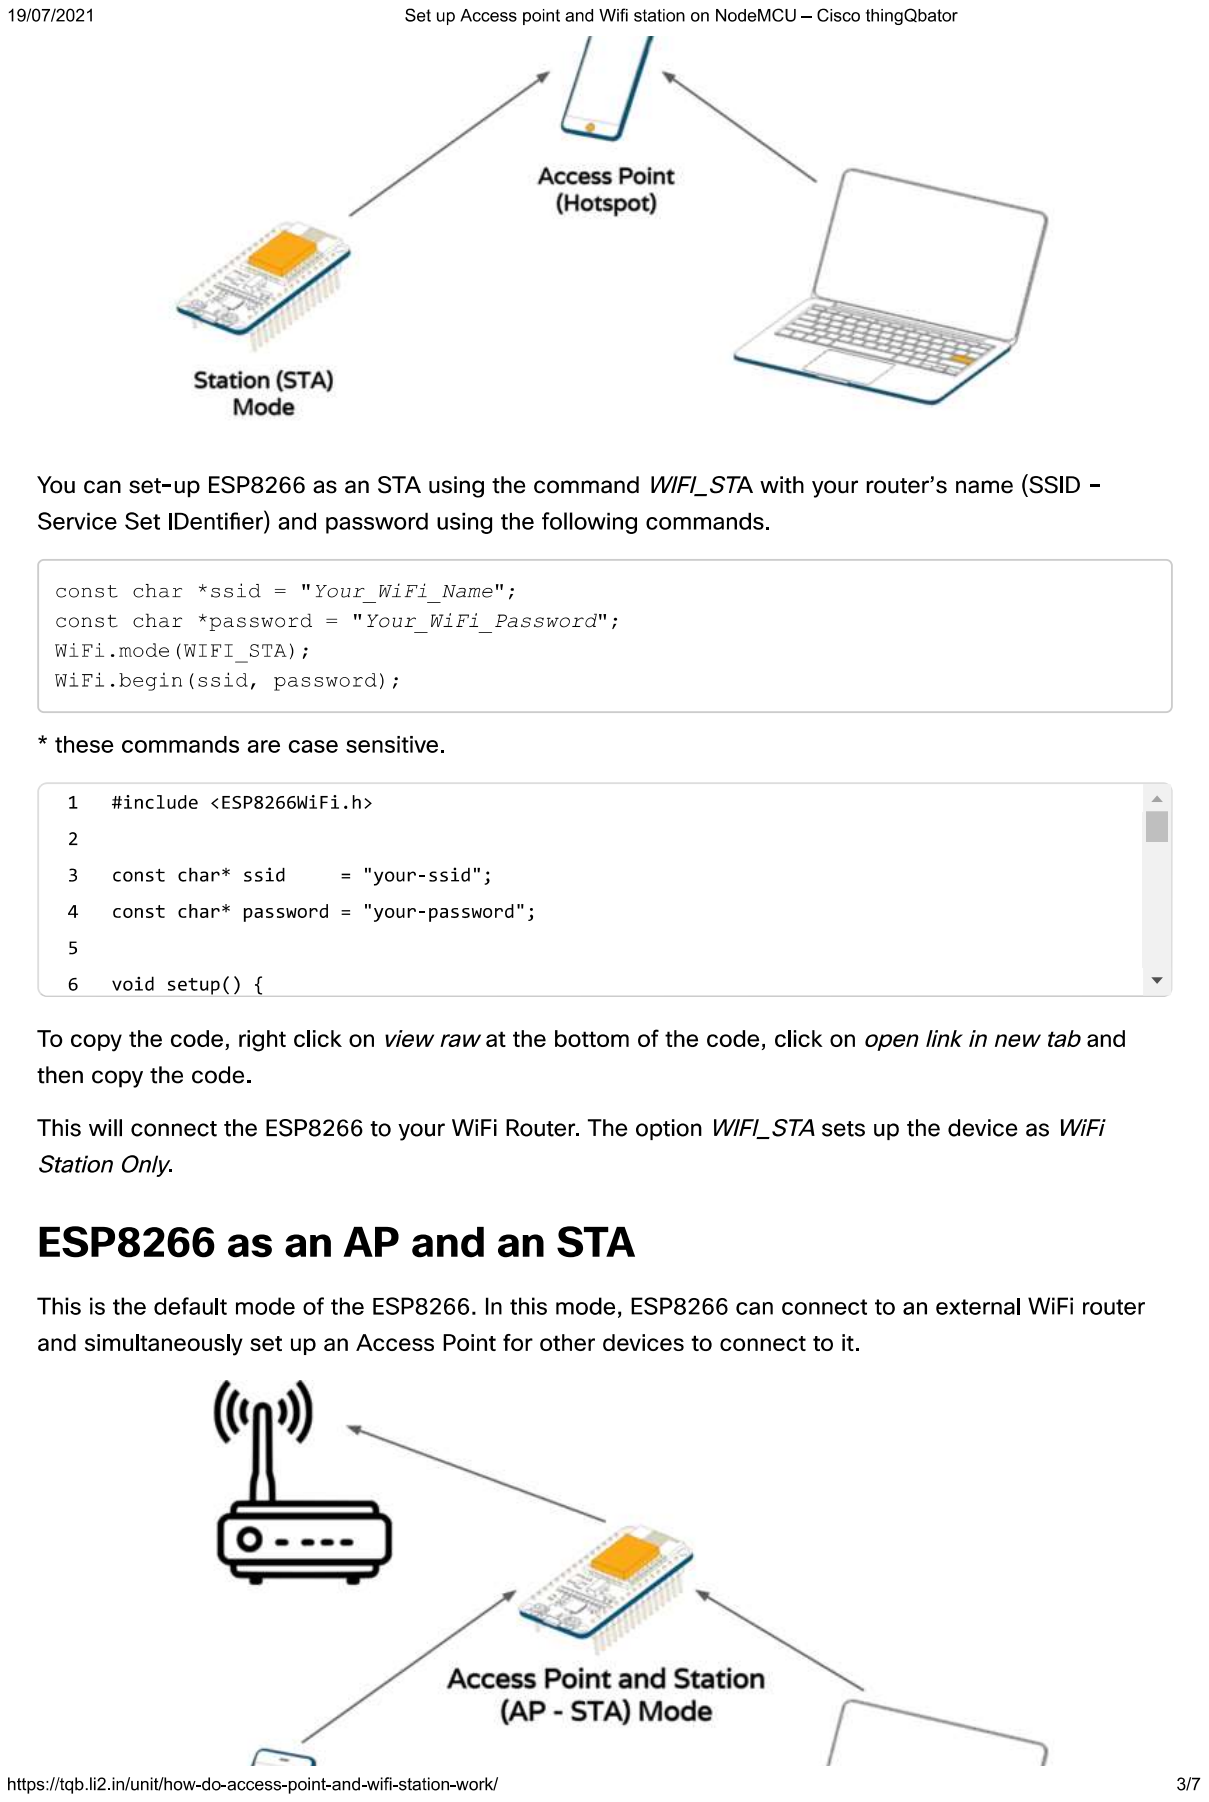
[picture p77: page 3]

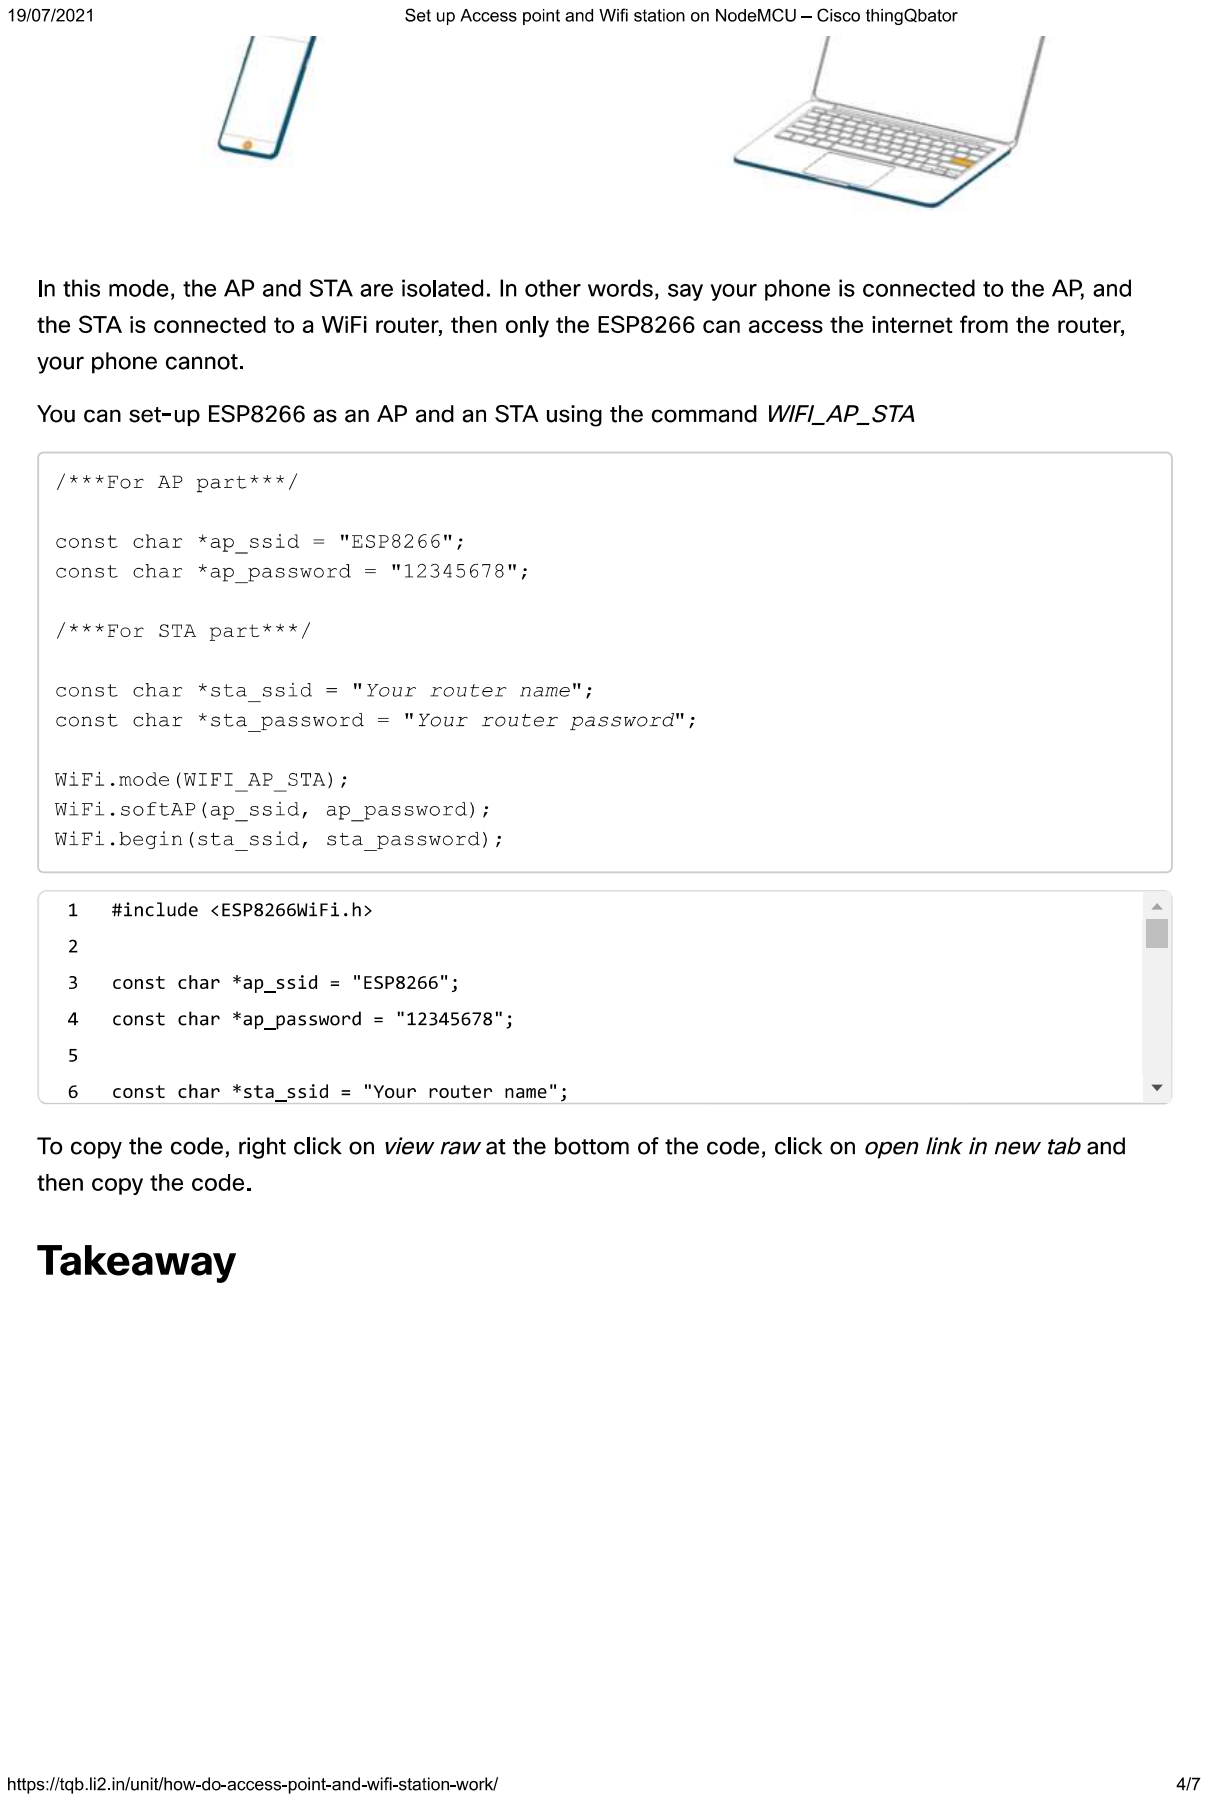
[picture p78: page 4]

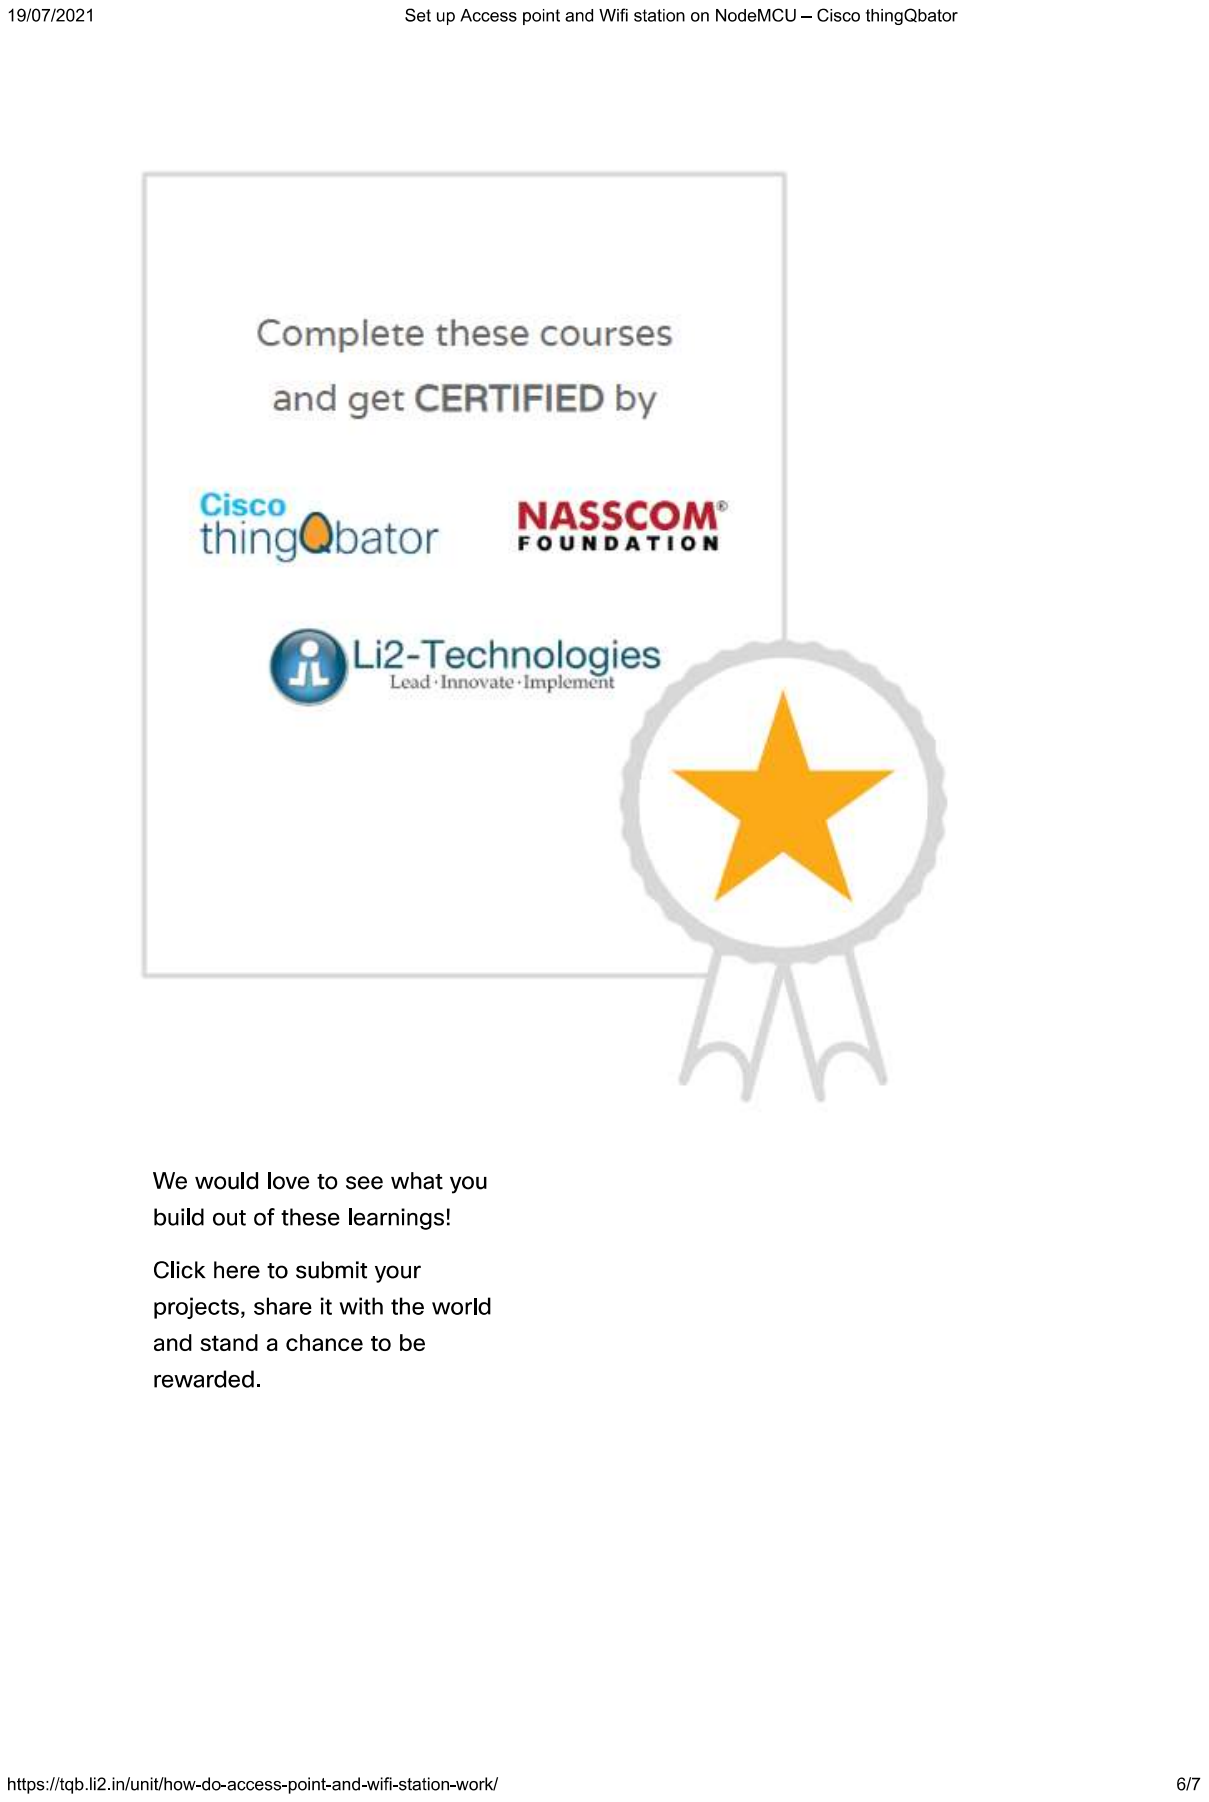
[picture p79: page 6]

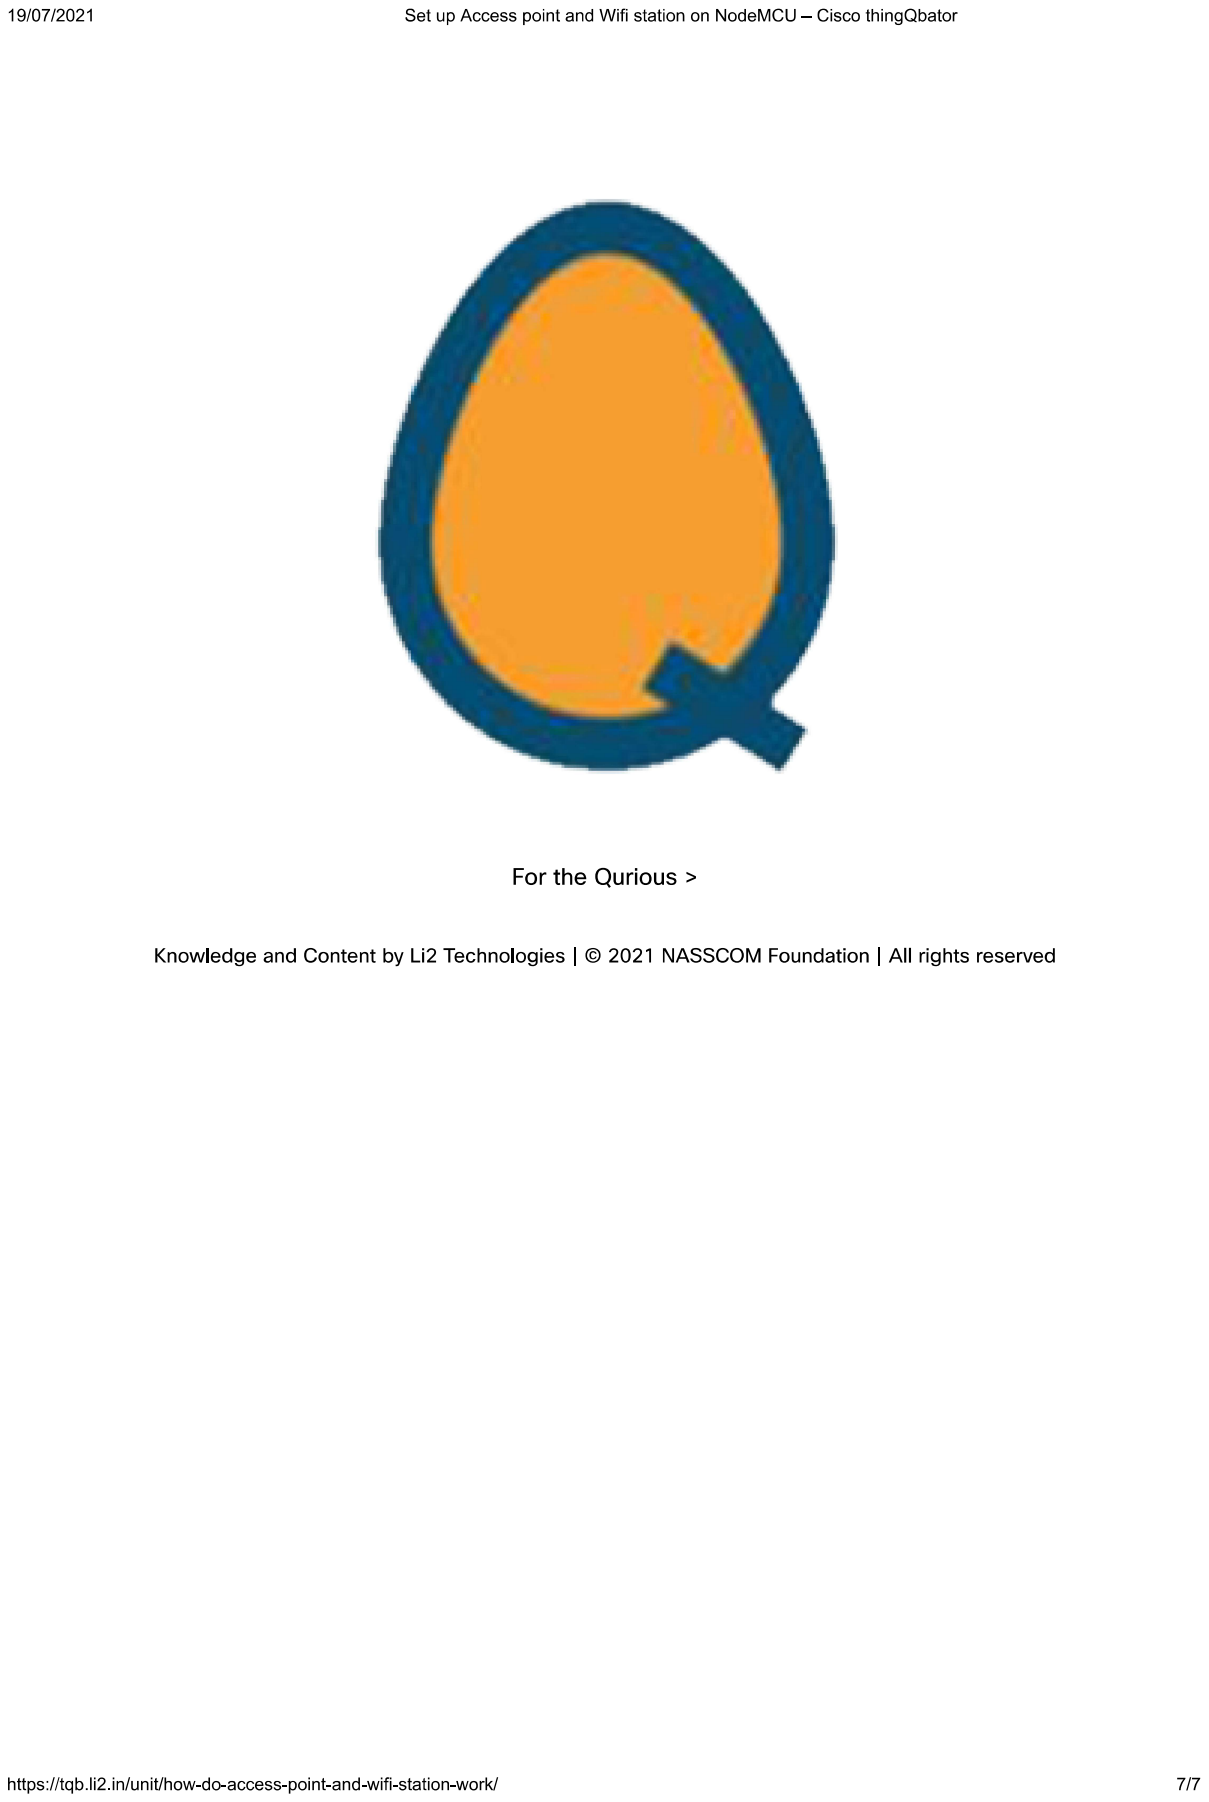
[picture p80: page 7]
