haz05/TCC--Batuta_Eletronica/Arquivos/Bibliografia/2- Ref Bibliograficas/4- Sensores de Aceleracao/MPU6050_Mouser_Eletronics.pdf

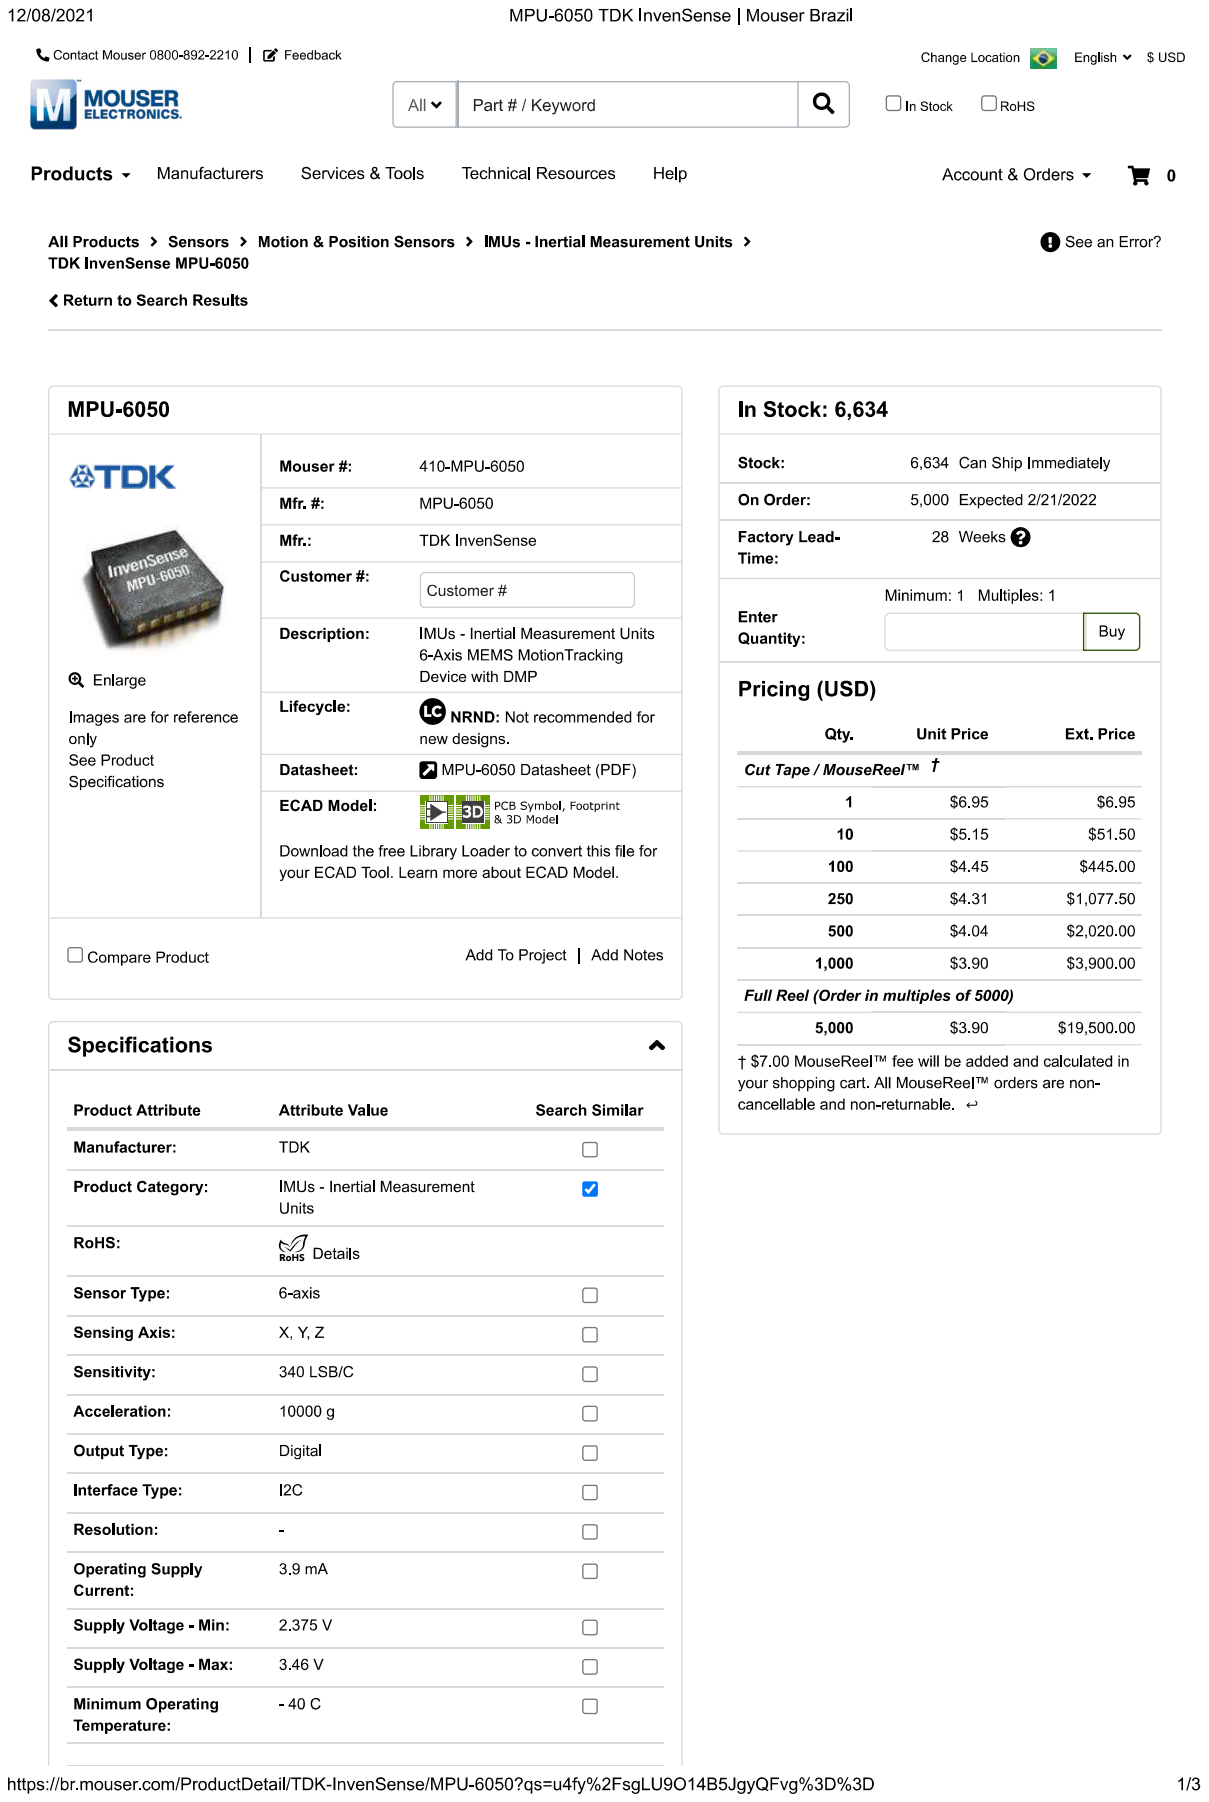
[picture p81: page 1]

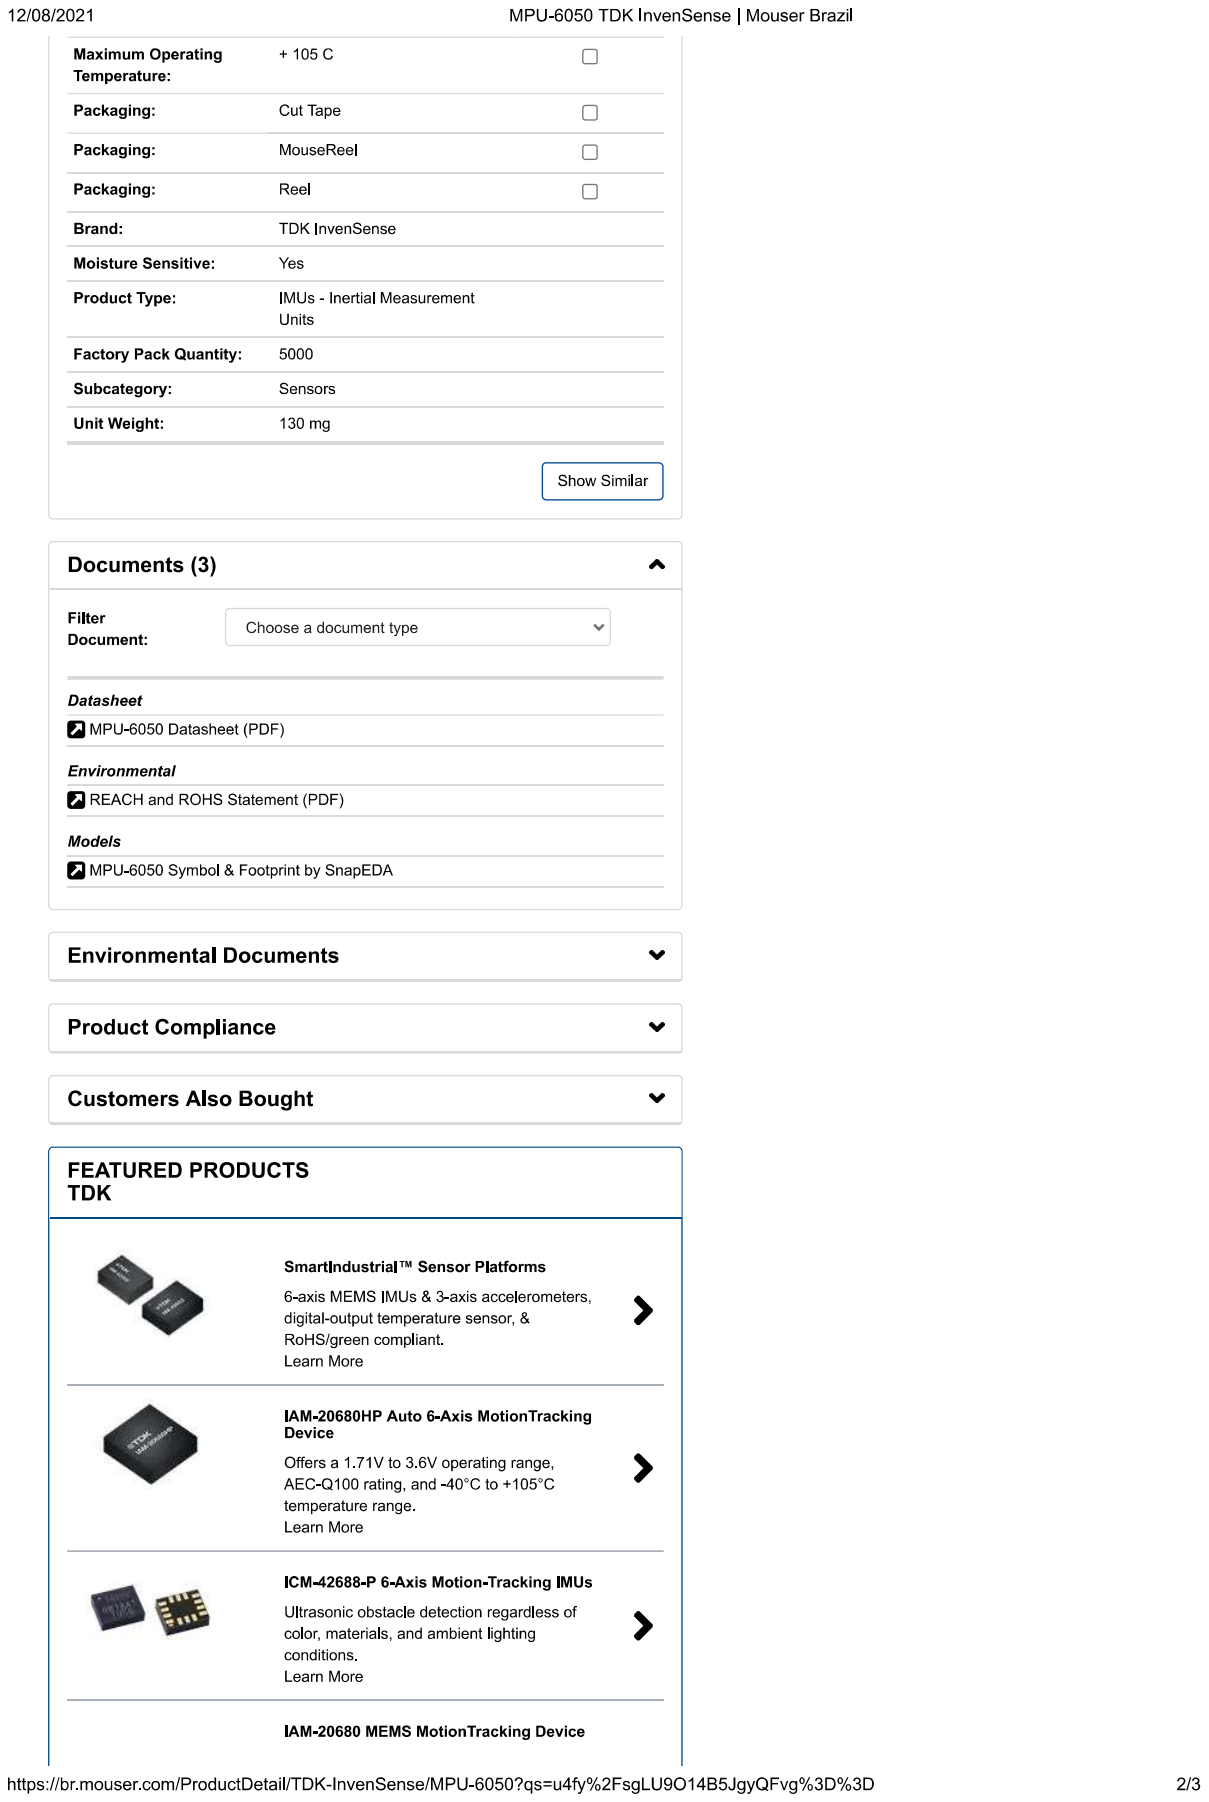
[picture p82: page 2]

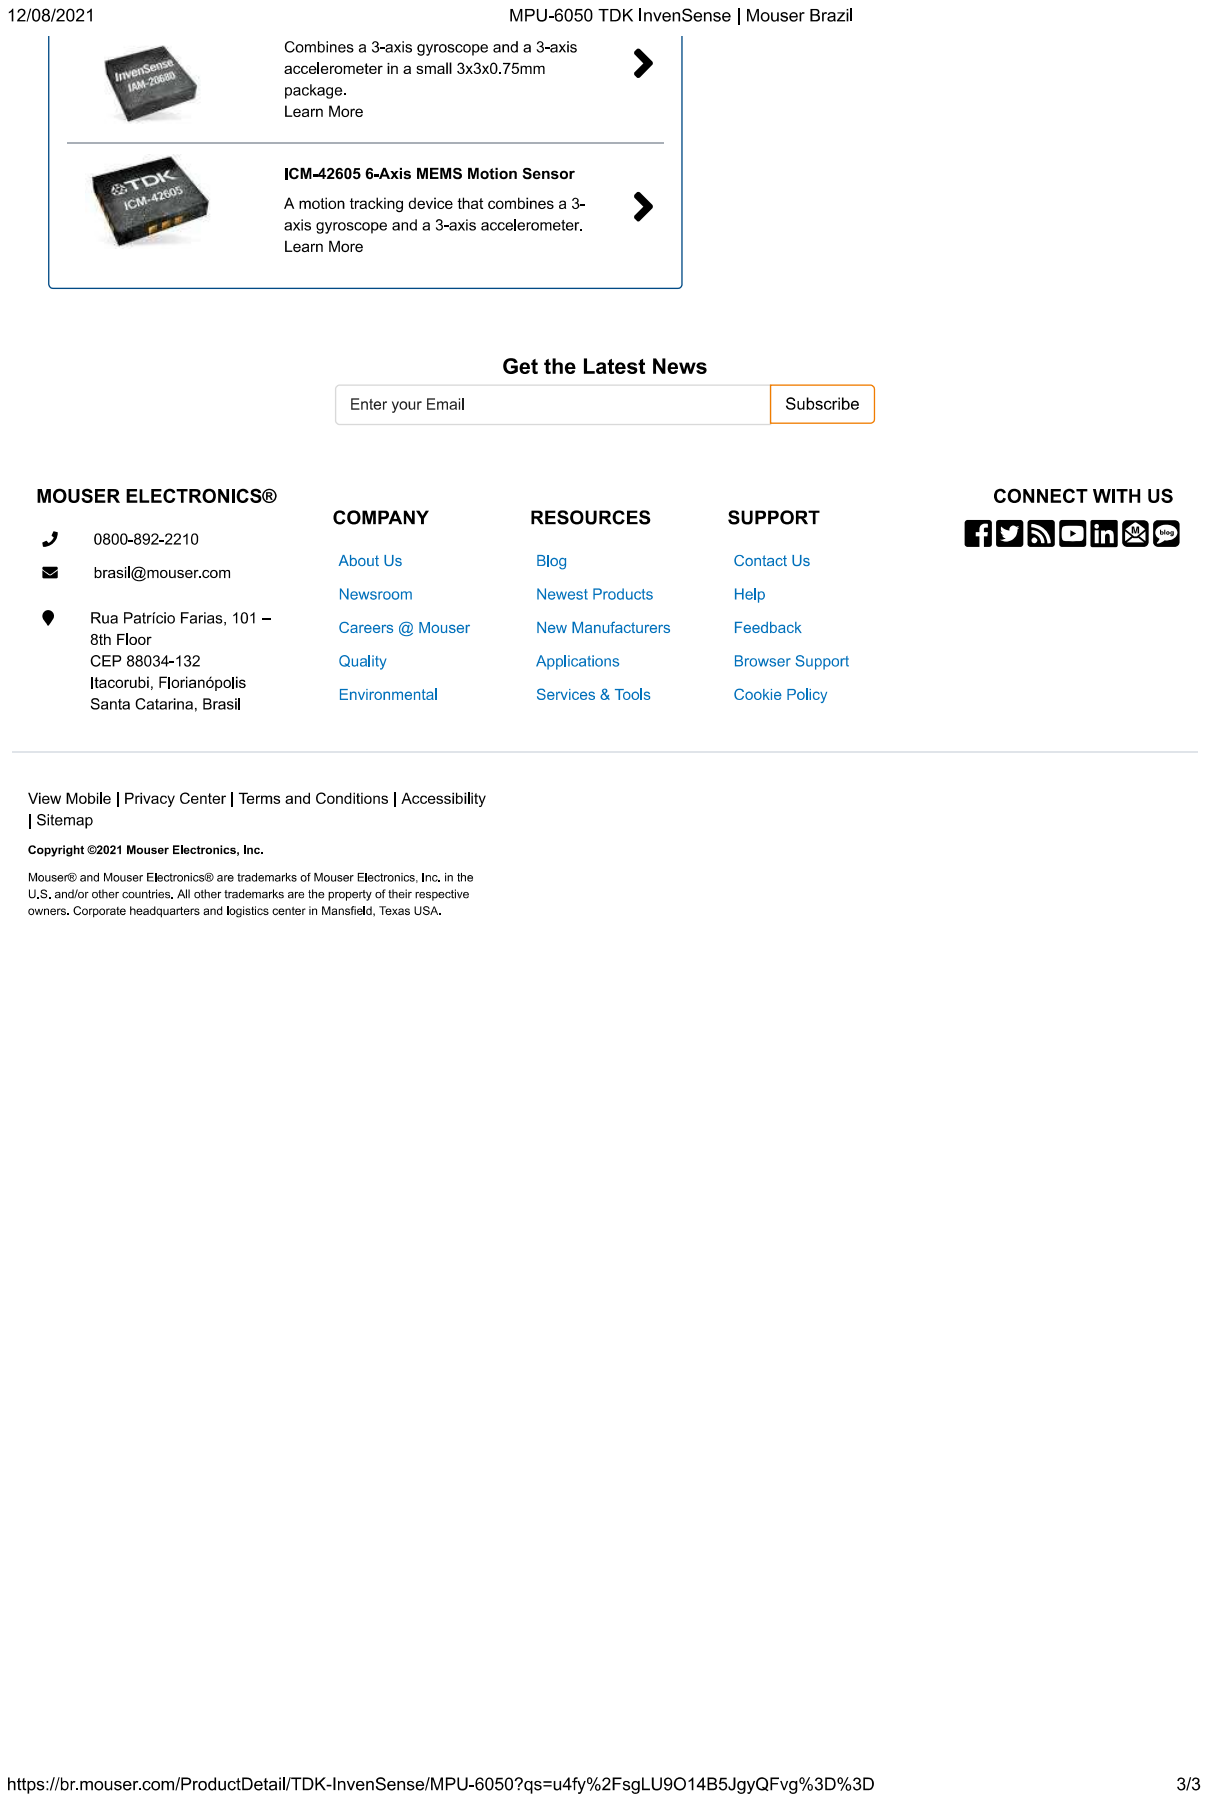
[picture p83: page 3]
