haz05/TCC--Batuta_Eletronica/Arquivos/Bibliografia/2- Ref Bibliograficas/5- Motor/Mouser_Eletronics_Vibration_Motors_site.pdf

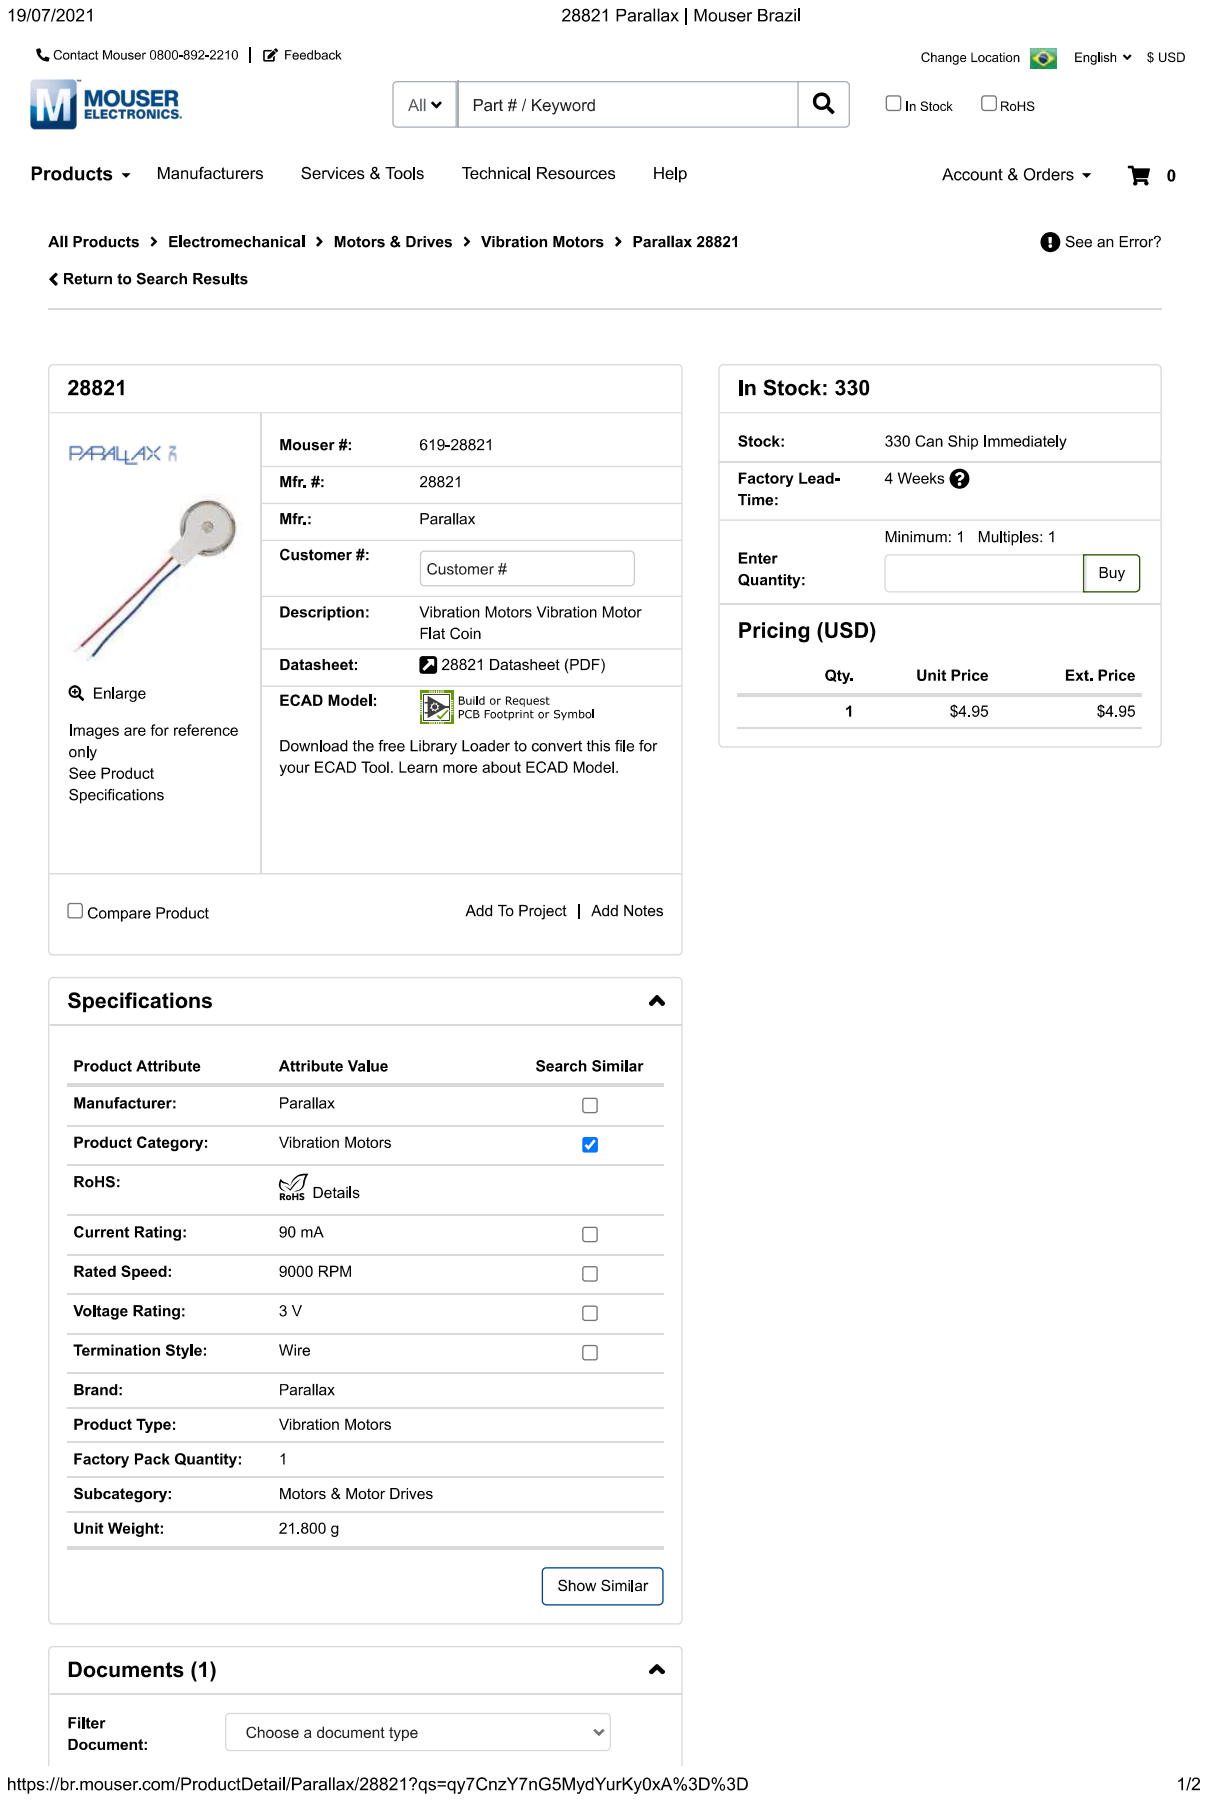
[picture p84: page 1]

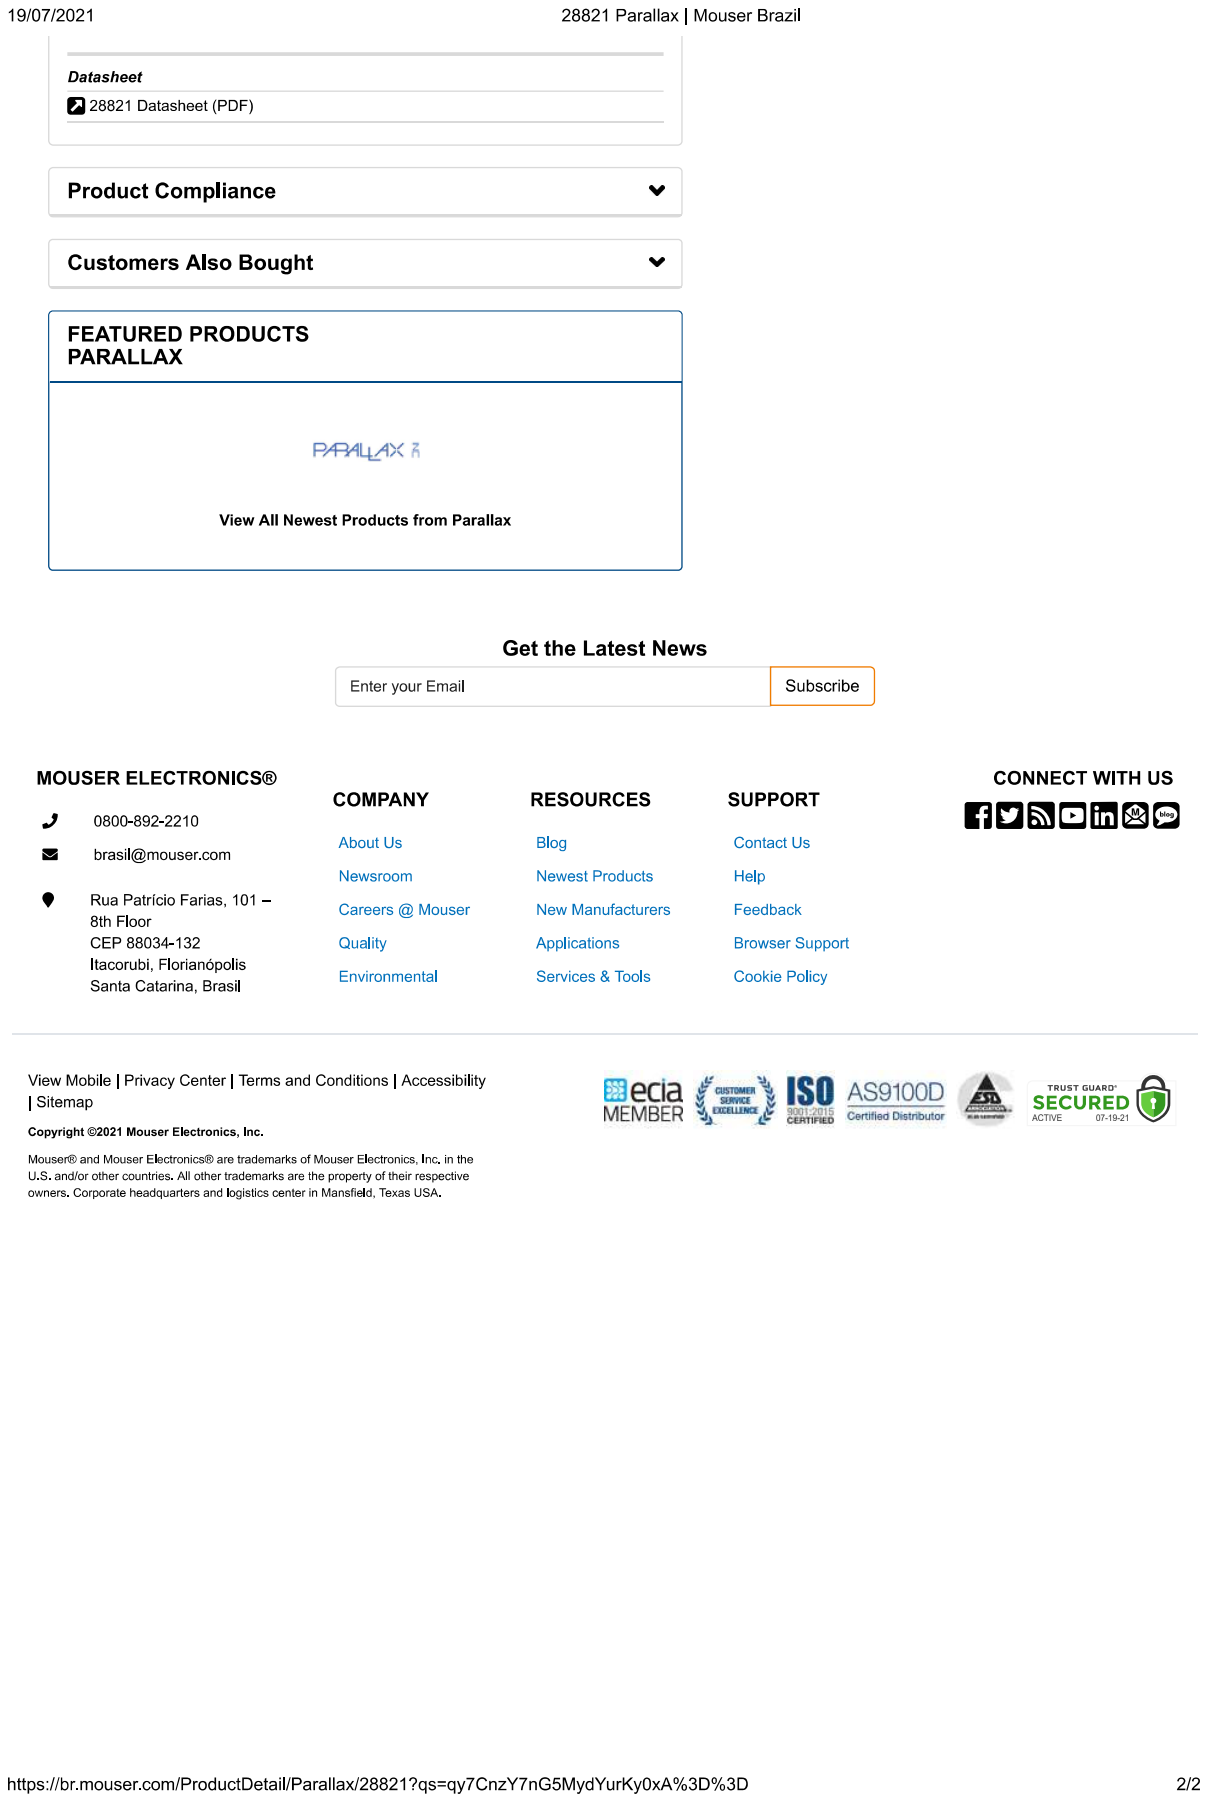
[picture p85: page 2]
