haz05/TCC--Batuta_Eletronica/(list of files, drawings)

Other design files:
Arquivos/Projeto-PCI/emissor_v2.pdsprj
Arquivos/Projeto-PCI/receptor_v2.pdsprj
