haz05/TCC--Batuta_Eletronica/Dados/Dados-Emissor/Config-Telemetry.txt

Telemetry Viewer v0.8 Settings

GUI Settings:

	tile column count = 6
	tile row count = 6
	time format = Only Time
	show 24-hour time = false
	show hint notifications = true
	hint notifications color = 0x00FF00
	show warning notifications = true
	warning notifications color = 0xFFFF00
	show failure notifications = true
	failure notifications color = 0xFF0000
	show verbose notifications = false
	verbose notifications color = 0x00FFFF
	show plot tooltips = true
	smooth scrolling = true
	show fps and period = false
	benchmarking = false
	antialiasing level = 16

1 Connections:

	connection type = UART
	port = COM5
	baud rate = 115200
	packet type = CSV
	sample rate hz = 1000
	transmit type = Text
	transmit data = 
	transmit appends cr = true
	transmit appends lf = true
	transmit repeats = false
	transmit repitition interval milliseconds = 1000
	transmit saved count = 0
	sync word = 0xAA
	sync word byte count = 1
	datasets count = 8

		dataset location = 0
		binary processor = null
		name = aX
		color = 0x00FF00
		unit = 
		conversion factor a = 1.0
		conversion factor b = 1.0

		dataset location = 1
		binary processor = null
		name = aY
		color = 0x0000FF
		unit = 
		conversion factor a = 1.0
		conversion factor b = 1.0

		dataset location = 2
		binary processor = null
		name = aZ
		color = 0xFF00FF
		unit = 
		conversion factor a = 1.0
		conversion factor b = 1.0

		dataset location = 3
		binary processor = null
		name = gX
		color = 0x6FFF6F
		unit = 
		conversion factor a = 1.0
		conversion factor b = 1.0

		dataset location = 4
		binary processor = null
		name = gY
		color = 0x6F6FFF
		unit = 
		conversion factor a = 1.0
		conversion factor b = 1.0

		dataset location = 5
		binary processor = null
		name = gZ
		color = 0xFF7EFF
		unit = 
		conversion factor a = 1.0
		conversion factor b = 1.0

		dataset location = 6
		binary processor = null
		name = sinal
		color = 0xFF0000
		unit = 
		conversion factor a = 1.0
		conversion factor b = 200.0

		dataset location = 7
		binary processor = null
		name = validação
		color = 0xFFAB76
		unit = 
		conversion factor a = 1.0
		conversion factor b = 200.0

		checksum location = -1
		checksum processor = null

1 Charts:

	chart type = Time Domain
	top left x = 0
	top left y = 0
	bottom right x = 4
	bottom right y = 4
	datasets = connection 0 location 0,connection 0 location 1,connection 0 location 6,connection 0 location 7
	bitfield edge states = 
	bitfield level states = 
	duration = 1000
	duration unit = Samples
	time axis shows = Sample Count
	autoscale y-axis minimum = true
	manual y-axis minimum = -1.0
	autoscale y-axis maximum = true
	manual y-axis maximum = 1.0
	show x-axis title = true
	show x-axis scale = true
	show y-axis title = true
	show y-axis scale = true
	show legend = true
	cached mode = false
	trigger mode = Disabled
	trigger affects = This Chart
	trigger type = Rising Edge
	trigger channel = connection 0 location 0
	trigger level = 0.0
	trigger hysteresis = 0.0
	trigger pre/post ratio = 20
